xuxian2102/autolock/reports/D5_POLARITY_DELTA_AUDIT.md

# D5 polarity delta audit

- Result: **PASS**
- Baseline SHA256: `0b13ca1eb79be087c1f54d9761513777bbcf02e400407ef353ba8222105b63a9`
- PCB exact approved transform: `True`
- Segment/via records byte-identical: `True`
- D5 pad centers swapped in place: `True`
- MCU schematic exact approved transform: `True`
- Design contract matches: `True`
- Errors: `0`
