xuxian2102/autolock/reports/GRAPHICS_SYNC_REGRESSION_STATUS.md

# Rev A 第二批图形封装同步回归状态

## 范围

- 仅处理 `C1、D1、D2、D5、F1、F2、J3、J4、L3、L4、Q1` 共 11 个实例；
- 同步隐藏 Value、参考号层、无效丝印弧等非铜层定义；
- 将 33 个文字子项和 29 个焊盘子项改为 KiCad 板坐标角度；
- Q1 修正一个被旧格式错误解释的 F.SilkS 弧，并移除重复的 footprint 自定义 `LCSC Part` 属性；
- 明确未处理 J2、U4、U5，也未修改其库或板上实例。

## 回归结果

| 检查 | 结果 |
|---|---|
| KiCad 10.0.6 官方 DRC | 仅 3 条 `lib_footprint_mismatch`：J2、U4、U5 |
| 官方未连接项 | 0 |
| 不同网络几何净距审计 | 0 errors，0 warnings |
| 物理铜连接 | 68 / 68 网络通过 |
| 非目标 PCB footprint | 未改变 |
| 走线、铜区、板级图形、网络 | 未改变 |
| 原理图 | 全部未改变 |
| 项目库变更集合 | 9 / 9 个预期文件，无额外文件 |
| 制造导出审计 | 13 / 13 文件，0 errors |
| 制造几何与上一归档对比 | 13 / 13 一致；仅生成时间不同 |
| 隔离重建测试 | 新生成 PCB 仍只剩 J2、U4、U5 三条库不匹配 |

## Q1 料号说明

`C16072` 没有从项目数据中删除。它仍存在于 `design_data.py`、原理图属性和 BOM 中。只删除了 Q1 板上 footprint 内重复的一份自定义属性，因为该副本的默认字体/格式语义会导致 KiCad 将板上实例判定为与项目库不一致。

## 结论

第二批 11 个图形封装同步通过官方 DRC、范围差分、连接、几何、制造导出和隔离重建验证。项目继续保持 **HOLD**；剩余 J2/U5 铜层关键差异和 U4 结构差异需要各自独立处理。
