xuxian2102/autolock/reports/PASSIVE_SYNC_REGRESSION_STATUS.md

# Rev A 第一批无源封装同步回归状态

## 范围

- 仅处理原 KiCad 10 DRC 报告中的 58 个常见无源实例；
- `C_0603_1608Metric`：28 个；
- `R_0603_1608Metric`：20 个；
- `C_1206_3216Metric`：10 个；
- 新增 6 个项目内封装变体，用于分别表达 `F.SilkS` 参考号和 `F.Fab` 参考号；
- 明确未处理：J2、U4、U5，以及所有不在 58 个引用清单中的实例。

## 回归结果

| 检查 | 结果 |
|---|---|
| PCB 库关联改动 | 58 / 58，符合清单 |
| 原理图 Footprint 属性改动 | 58 / 58，符合清单 |
| 目标器件旋转语义 | 174 个文字子项角度、116 个焊盘子项角度已改为 KiCad 板坐标角度 |
| 目标器件焊盘编号、网络、中心坐标、尺寸与形状 | 未改变 |
| 非目标 PCB footprint | 未改变 |
| 走线、铜区、板级图形、网络 | 未改变 |
| 非目标原理图符号及其他字段 | 未改变 |
| 不同网络几何净距审计 | 0 errors，0 warnings |
| 物理铜连接 | 68 / 68 网络通过 |
| 制造导出审计 | 13 / 13 文件，0 errors |
| 制造几何与同步前归档对比 | 13 / 13 一致；仅 Gerber CreationDate 不同 |
| BOM/CPL | 95 个 BOM 引用，93 个 CPL 引用，21 个 LCSC 仍待确认 |

## 封装告警复核

同步前的 KiCad 10.0.5 官方 DRC 文件包含 72 条 `lib_footprint_mismatch`。重新取得官方 KiCad 10.0.6 后，对正式修正板运行原生 DRC：

- 原生 DRC 总违规：14，且全部为 `lib_footprint_mismatch`；
- 未连接项：0；
- 已消除本批 58 条；
- 图形/字段差异：11；
- U4 结构复核：1；
- J2/U5 铜焊盘复核：2；
- 合计仍保留：14。

正式报告为 `KICAD10_DRC_PASSIVE_ROTATION_FIXED_OFFICIAL.json`，其中记录 `kicad_version: 10.0.6`。另外以同步完成后的归档为基线做严格差分：58 个目标之外的 footprint、板级数据与全部原理图未变，13 份制造文件物理几何一致。

## 结论

第一批 58 个无源封装同步本身通过范围、连接、几何和制造回归。项目继续保持 **HOLD**，本批之外的 14 条封装告警没有被处理。
