xuxian2102/autolock/reports/REV_A_RELEASE_STATUS.md

# Rev A 发布状态

## 已完成

- 120 个 PCB footprint、68 个电气网络；
- 4 层 150 × 75 mm 布线；
- 真实自定义焊盘几何纳入审计；
- 68/68 网络物理铜皮连通；
- 不同网络最小 0.10 mm 净距审计：0 errors、0 warnings；
- NFC 与 ESP32 天线四层禁铜检查；
- PN7161 中心焊盘采用 NXP SOT618-1 官方 3 × 3、0.60 × 0.60 mm 钢网开窗，约 19.3% 锡膏面积；
- KiCad 10.0.6 官方导出的 11 层 Gerber 与 PTH/NPTH Excellon，共 13 个文件；已检查 X2 属性、毫米单位、文件结尾及钻孔数量；
- PTH 240 圆孔 + 4 长槽、NPTH 6 圆孔与源板数量一致；
- JLC BOM 草稿、CPL 草稿、顶层装配图、分层铜皮预览；
- 裸板上传 ZIP 和完整评审包。
- 第一批 58 个常见无源封装已完成项目库同步，并补齐旋转实例的 174 个文字子项角度与 116 个焊盘子项角度；
- 第二批 11 个图形/字段类封装已同步；其中 Q1 的错误丝印弧已改为正确的小型引脚 1 缺口，重复的 footprint 级 LCSC 属性已移除，但 `C16072` 仍保留在设计清单、原理图与 BOM；
- KiCad 10.0.6 原生 DRC 已正式复跑：`lib_footprint_mismatch` 从 72 条降至 0 条，0 个未连接项、0 条违规；
- U4 已换成 KiCad 10 原生 footprint 块并同步项目库；专用基线差分确认 61 个焊盘、网络、四层天线禁铜区、位置及制造几何均未改变；
- J2 已按 HRO TYPE-C-31-M-12 的机械结构完成复核：两个 0.60 mm 塑料定位柱孔保持 NPTH，18 个焊盘/外壳固定脚的铜、钻孔、网络和物理方向未改变；
- U5 已按 NXP SOT618-1 官方封装复核：40 个外围焊盘和 4.10 × 4.10 mm 中心铜焊盘保持不变；只把错误的整面锡膏改为九个 0.60 mm 开窗，并把 courtyard 改为 7.25 × 7.25 mm；
- U5 专用基线差分通过：U5 之外的 PCB 文本逐字节一致，41 个铜焊盘、网络、位置和物理方向均未变化；13 份制造文件中只有顶层锡膏层发生预期变化；
- 生成链已在隔离副本中重建验证：全新生成 PCB 为 0 条封装库不匹配，U4、J2、U5 与此前两批同步均不会回退。
- 原 21 个采购料号缺口已全部完成 LCSC/MPN/厂家复核并同步到设计源、原理图和 BOM；
- D5 已按标准 LED 极性修正：1=K 接 GND、2=A 经 R9 接 `STATUS_LED`，采用 C12624 / KT-0603G；D5 原地旋转 180°，全部走线和过孔逐字节未变；
- D5 专用基线差分、项目几何检查、68/68 物理连通和 KiCad 10 PCB DRC 均通过，DRC 为 0 条违规、0 个未连接。
- 一键发布链已固化为：项目几何/连通检查 → KiCad 10 官方 DRC → 兼容 BOM/CPL 导出 → KiCad 10 官方制造文件覆盖 → 13/13 制造审计 → CPL 93/93 定位/旋转审计 → 官方逐层图渲染；fallback Gerber 不会进入最终 ZIP；
- 官方逐层图本地目检通过：左侧 NFC 区域内层禁铜、U4 板边天线下方四层留空、U5 顶层钢网为 3 × 3，丝印文字和圆弧均保留；
- CPL 本地语义审计通过：93/93 个顶层 SMT 位号、中心坐标、层面和板内旋转与 PCB 一致；D5 为 270°。嘉立创元件库模型的零度定义仍必须在网页预览中确认。

## 尚未放行

1. 嘉立创 PCBA 预览中尚未逐颗确认旋转，尤其 D5 阴极方向；
2. 官方 Gerber 已在本地逐层目检，但尚未在嘉立创在线查看器中确认其平台解析结果；
3. PCB 天线没有实板 VNA 调谐，HomeKey 穿门距离未知；
4. 固件、待机功耗、舵机机构和堵转保护尚未验证。
5. 当前便携 KiCad 的原理图 ERC/PDF 子命令对未修改基线也会 bus error；`.kicad_sch` 源文件是权威版本，现有 PDF 仍是 D5 修正前版本。

结论：**电气与导出完整性通过；生产放行保持 HOLD。**
