xuxian2102/autolock/reports/FINAL_LOCAL_PRODUCTION_REVIEW.md

# Rev A 最终本地生产评审

## 结论

**本地电气、几何、制造导出和装配坐标回归全部通过；生产状态保持 HOLD。**

HOLD 不代表本地审计失败，而是仍缺嘉立创网页解析确认、实时库存确认和首板 RF/电源/机构测试。当前文件可以用于进入嘉立创上传预览阶段，但不应在未复核预览的情况下直接付款。

## 已通过的发布门

| 检查项 | 结果 |
|---|---|
| D5 受控基线差分 | PASS；只发生批准的极性/朝向/采购字段变化，走线和过孔逐字节未变 |
| 项目几何审计 | PASS；0 errors / 0 warnings，最小审计净距 0.10 mm |
| 物理铜连接 | PASS；68/68 个有焊盘网络连通，0 个断网 |
| KiCad 10.0.6 官方 PCB DRC | PASS；0 violations / 0 unconnected |
| 制造导出 | PASS；KiCad 官方 11 层 Gerber + PTH/NPTH，共 13/13 文件 |
| 钻孔 | PASS；PTH 240 圆孔 + 4 长槽，NPTH 6 圆孔 |
| BOM | PASS；95 个有效位号，SMT 缺失 LCSC 数为 0 |
| CPL | PASS；93/93 个顶层 SMT 位号、中心坐标、层面和板内旋转一致 |
| 官方逐层图 | PASS；11 层及 D5/U5/U4/J2 四个关键区域已渲染复核 |

## 制造图关键确认

- 最终制造文件全部来自 KiCad 10.0.6 官方导出；兼容导出只提供中间数据，发布链会在审计与打包前强制由官方文件覆盖。
- 顶层/底层丝印保留参考文字、板名和圆弧，不存在 fallback 的文字/旧式圆弧缺失。
- 左侧 NFC 天线完整，内层在 NFC 区域保持禁铜。
- U4 位于板边，其天线下方 F.Cu、In1.Cu、In2.Cu、B.Cu 四层均留空。
- U5 中心铜焊盘保持 4.10 × 4.10 mm，顶层钢网为九个 0.60 × 0.60 mm 分窗。
- J2 的两个 0.60 mm 定位柱孔为 NPTH，四个外壳固定脚为镀铜长槽。
- D5 为 C12624 / KT-0603G，CPL 旋转 270°；1/K 接 GND，2/A 经 R9 接状态灯网络。

## 发布链顺序

1. 几何与物理连通审计；
2. KiCad 10 官方 PCB DRC；
3. BOM/CPL 与兼容制造数据生成；
4. KiCad 10 官方 Gerber/钻孔覆盖；
5. 固定 13 文件集合、格式、钻孔和装配数据审计；
6. CPL 93/93 定位/旋转审计；
7. KiCad 官方逐层图与关键区域渲染；
8. Gerber ZIP、评审包与 SHA-256 清单生成。

任何步骤失败都会中止构建，不会生成新的发布包。

## 尚未完成的外部放行门

1. 在嘉立创 Gerber 查看器确认 4 层顺序、板框、长槽、NFC/U4 禁铜和 U5 钢网；
2. 在嘉立创 PCBA 预览逐颗确认库模型零度定义，重点检查 D5、J2、U4、U5 和 X1；
3. 下单前重新确认 LCSC 实时库存、替代提示和混装工艺；
4. 首板完成 NFC 天线 VNA 调谐、HomeKey 穿门距离测试；
5. 首板完成固件、待机功耗、舵机电源、堵转保护和机构验证。

## 原理图 PDF 限制

当前便携 KiCad 10 的原理图 ERC/PDF 子命令在修正前基线和当前文件上都会触发 `bus error`。因此 `.kicad_sch` 是权威原理图；现有 PDF 仍是 D5 修正前的参考版本并已明确标注，不得据其判断 D5 极性。该限制不影响 PCB DRC、Gerber、钻孔、BOM 或 CPL 的官方导出和审计。
