xuxian2102/autolock/reports/PCB_CONNECTIVITY.csv

Net | Layer policy | Unique endpoints | MST edges | New vias | A* visited nodes | Status
BAT_SYS | F.Cu/In2.Cu | 14 | 13 | 14 | 0 | PASS (explicit current tree)
PN_VMID | F.Cu | 2 | 1 | 143 | 4 | PASS
PN_TX1 | F.Cu | 2 | 1 | 143 | 451 | PASS
PN_TX2 | F.Cu | 2 | 1 | 143 | 857 | PASS
PN_RXN | F.Cu | 2 | 1 | 143 | 1327 | PASS
PN_RXP | F.Cu | 2 | 1 | 143 | 5717 | PASS
RF_N0 | F.Cu | 5 | 4 | 143 | 1803 | PASS
RF_N1 | F.Cu | 5 | 4 | 143 | 515 | PASS
RF_P0 | F.Cu | 5 | 4 | 143 | 2509 | PASS
RF_P1 | F.Cu | 5 | 4 | 143 | 840 | PASS
ANT_P | F.Cu | 2 | 1 | 143 | 87 | PASS
RF_N2 | F.Cu | 3 | 2 | 143 | 2118 | PASS
RF_P2 | F.Cu | 3 | 2 | 143 | 1863 | PASS
ANT_N | F.Cu | 2 | 1 | 143 | 87 | PASS
EXT_ANT_N | F.Cu | 2 | 1 | 143 | 1203 | PASS
EXT_ANT_P | F.Cu | 2 | 1 | 143 | 449 | PASS
RXN_AC | F.Cu | 2 | 1 | 143 | 2 | PASS
RXP_AC | F.Cu | 2 | 1 | 143 | 2 | PASS
XTAL1 | F.Cu | 3 | 2 | 143 | 1467 | PASS
XTAL2 | F.Cu | 3 | 2 | 143 | 9484 | PASS
SERVO_PWM | F.Cu | 2 | 1 | 143 | 146601 | PASS
SERVO_6V | F.Cu | 7 | 6 | 141 | 15796 | PASS
SERVO_6V_OUT | F.Cu | 3 | 2 | 141 | 73543 | PASS
SW_SERVO | F.Cu | 3 | 2 | 141 | 249 | PASS
BAT_FUSED | F.Cu | 6 | 5 | 141 | 1294 | PASS
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
