xuxian2102/autolock/reports/PHYSICAL_CONNECTIVITY_AUDIT.txt

PHYSICAL COPPER CONNECTIVITY AUDIT
========================================================================
Electrical nets with pads checked: 68
Disconnected nets: 0

RESULT: PASS — every electrical net's component terminals share copper
