xuxian2102/autolock/reports/final-review/B_Cu.png

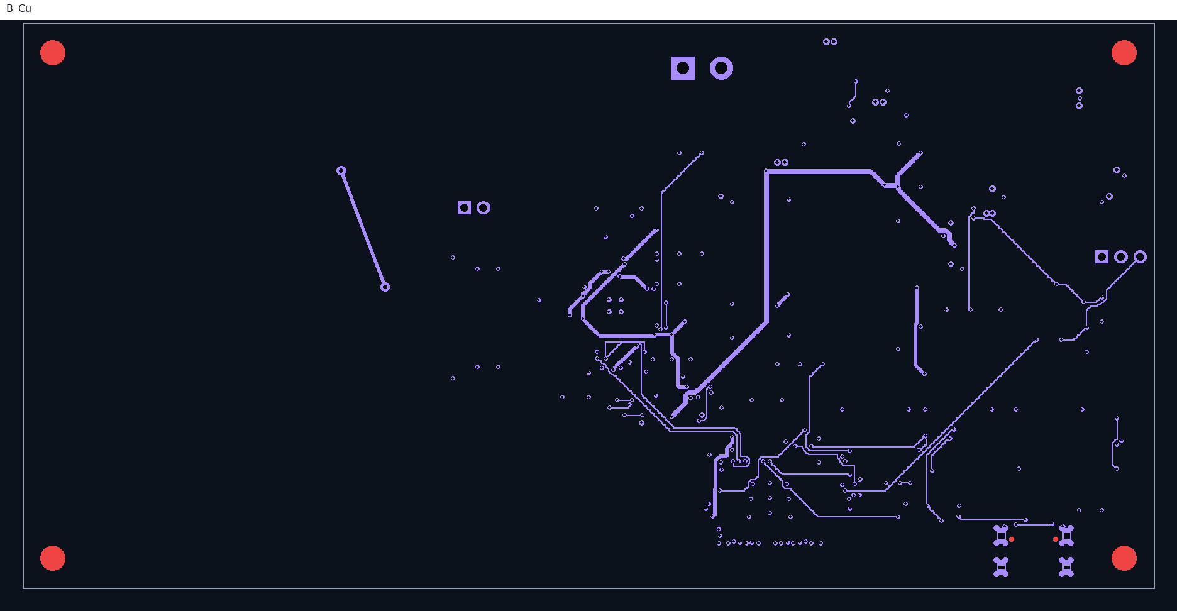
reports/final-review/B_Cu.png
