xuxian2102/autolock/reports/final-review/B_Mask.png

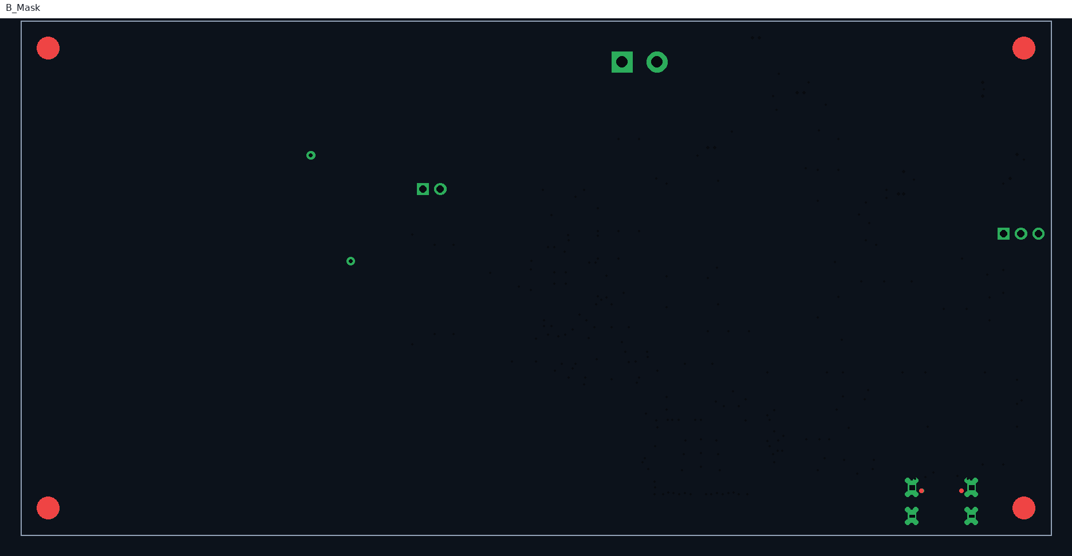
reports/final-review/B_Mask.png
