xuxian2102/autolock/reports/final-review/B_Paste.png

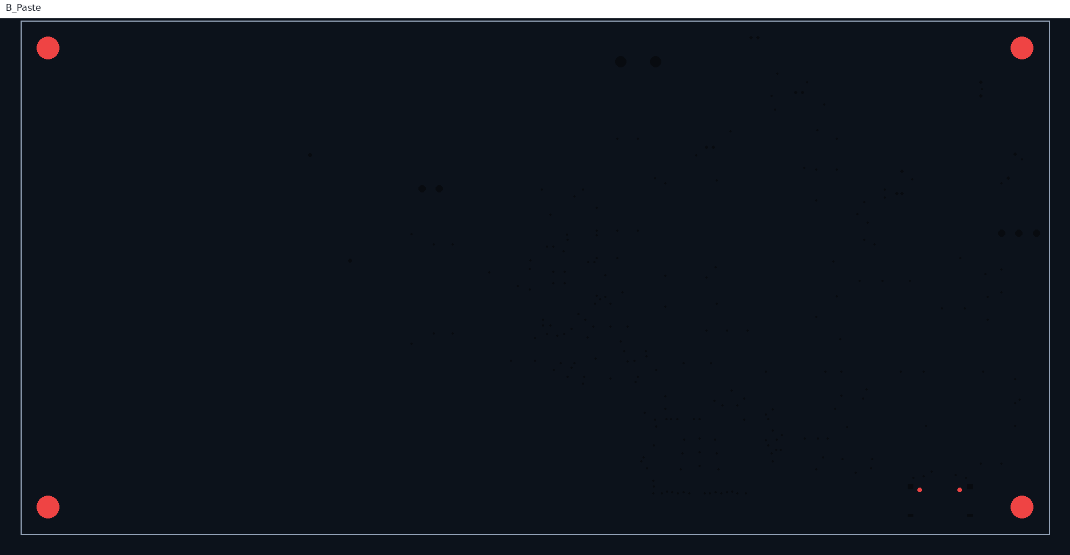
reports/final-review/B_Paste.png
