xuxian2102/autolock/reports/final-review/cpl_orientation_overlay.png

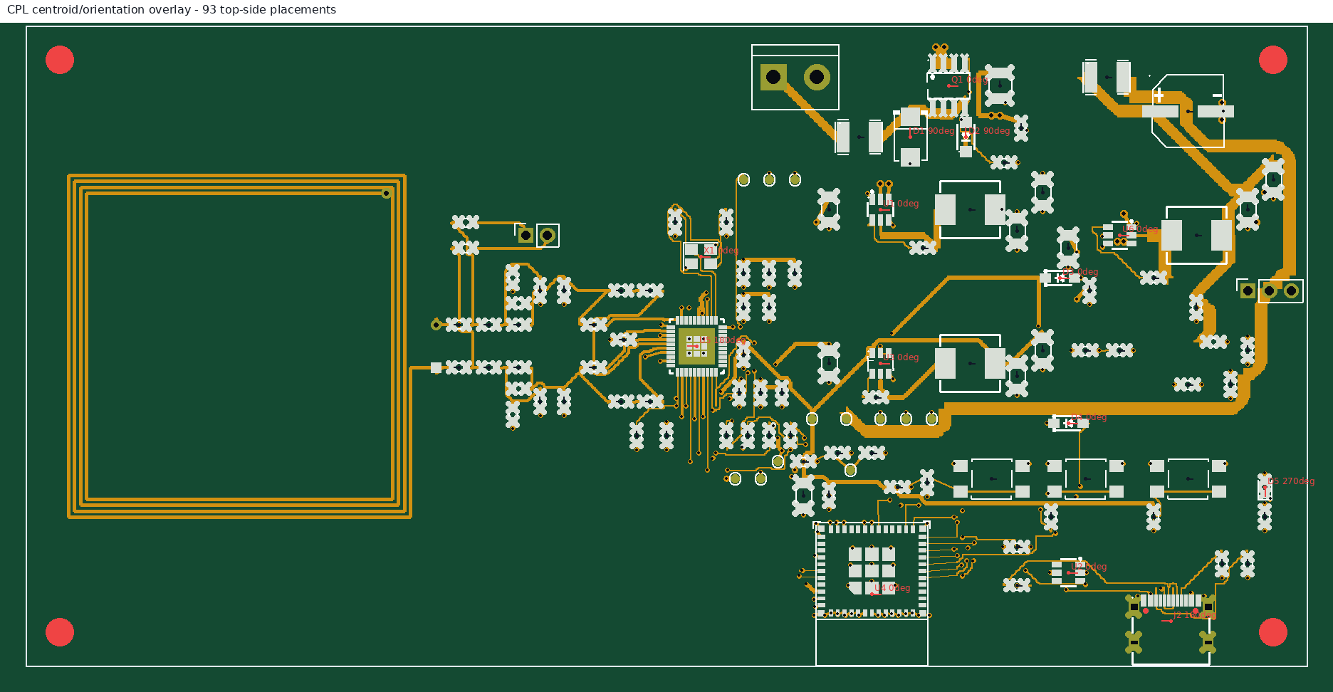
reports/final-review/cpl_orientation_overlay.png
