xuxian2102/autolock/reports/final-review/critical_crops.png

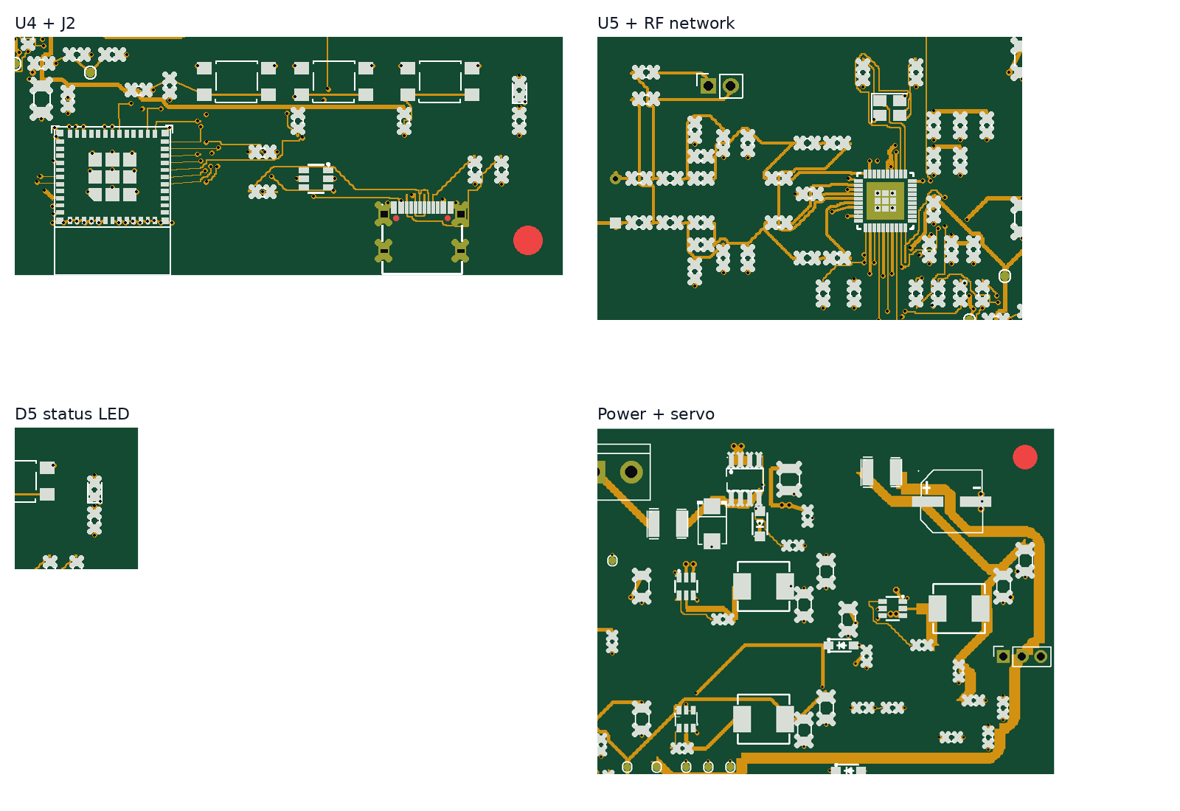
reports/final-review/critical_crops.png
