xuxian2102/autolock/reports/final-review/drill_map.png

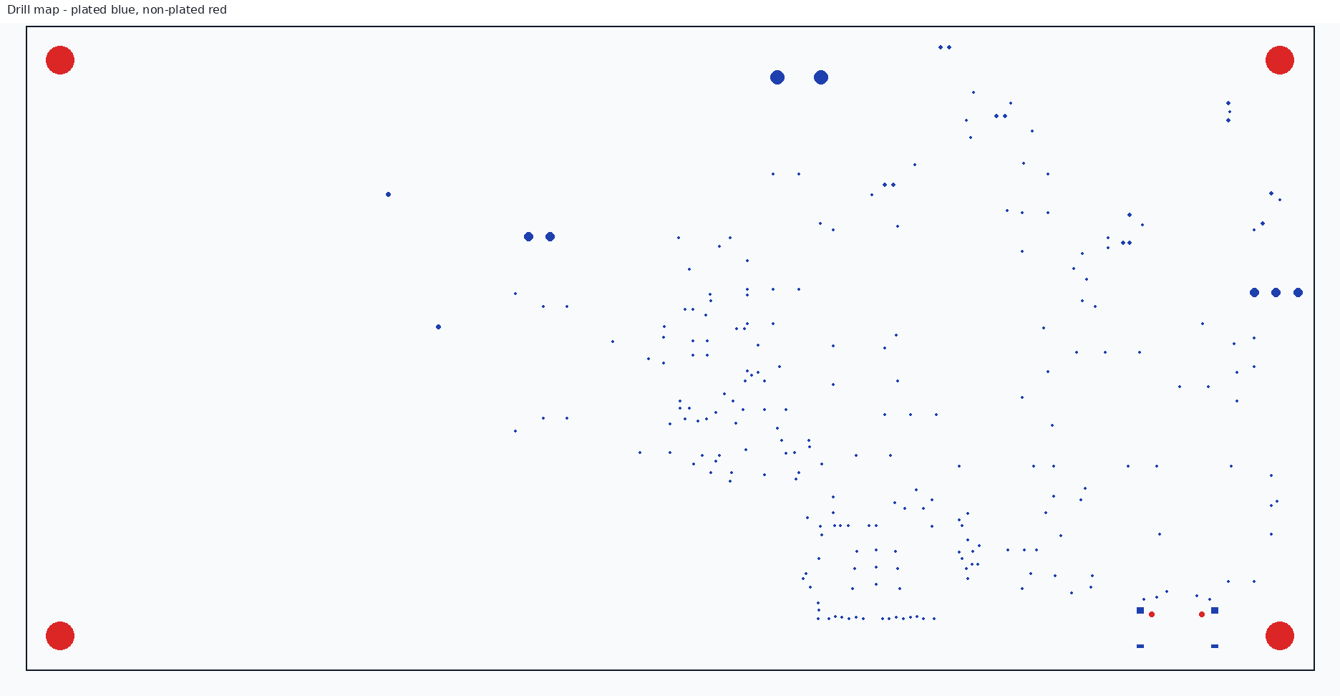
reports/final-review/drill_map.png
