xuxian2102/autolock/reports/final-review/F_Mask.png

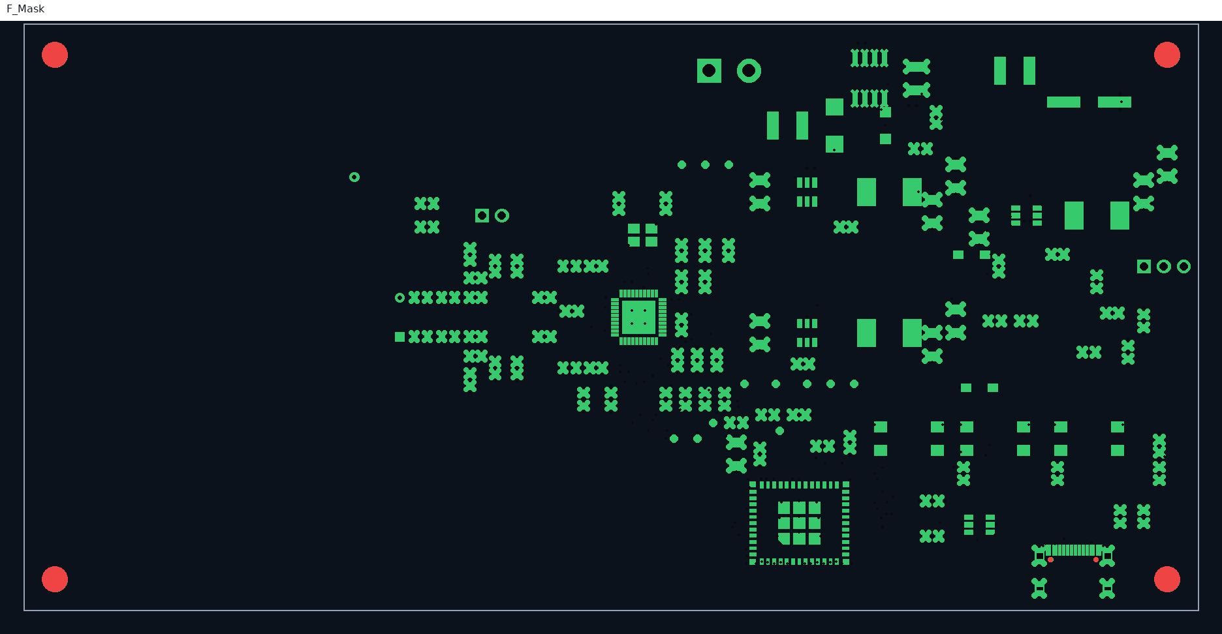
reports/final-review/F_Mask.png
