xuxian2102/autolock/reports/final-review/F_Paste.png

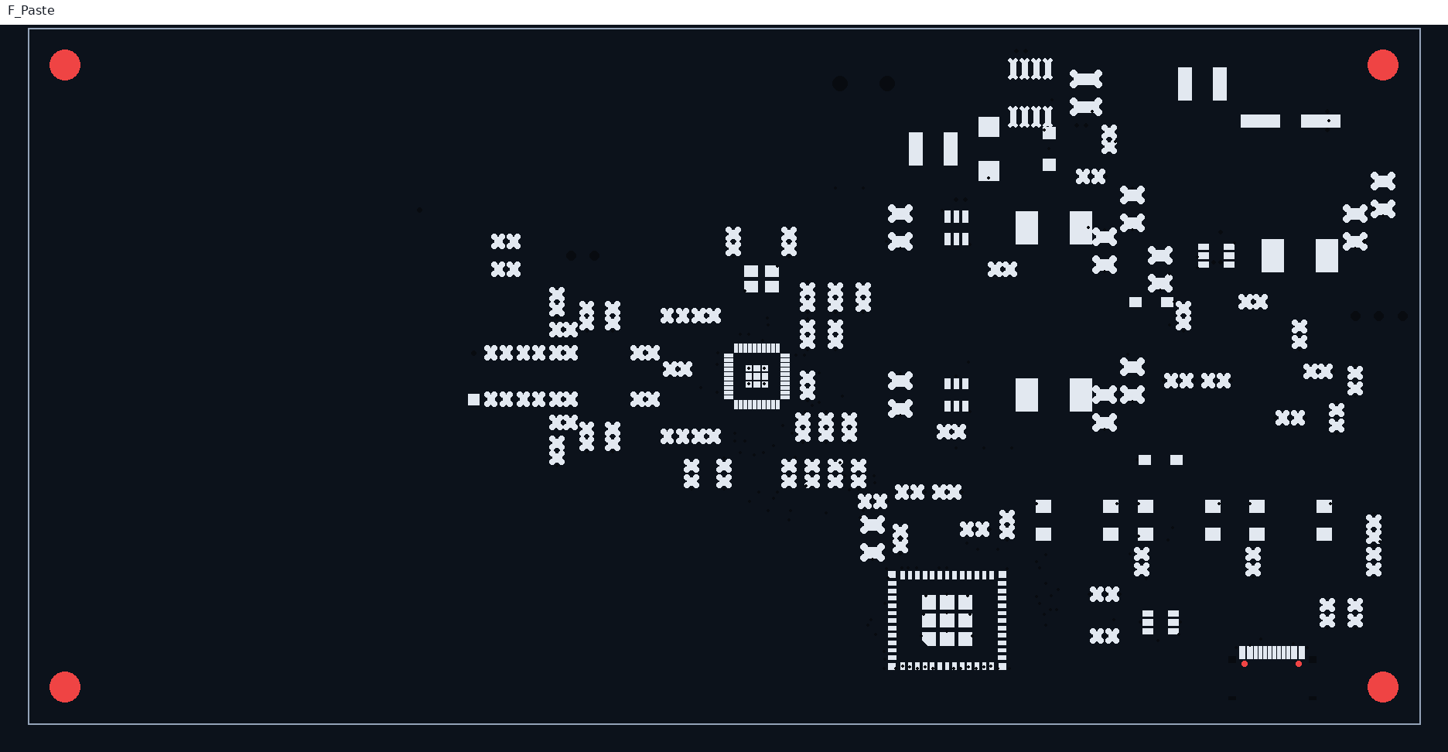
reports/final-review/F_Paste.png
