xuxian2102/autolock/reports/final-review/F_Silk.png

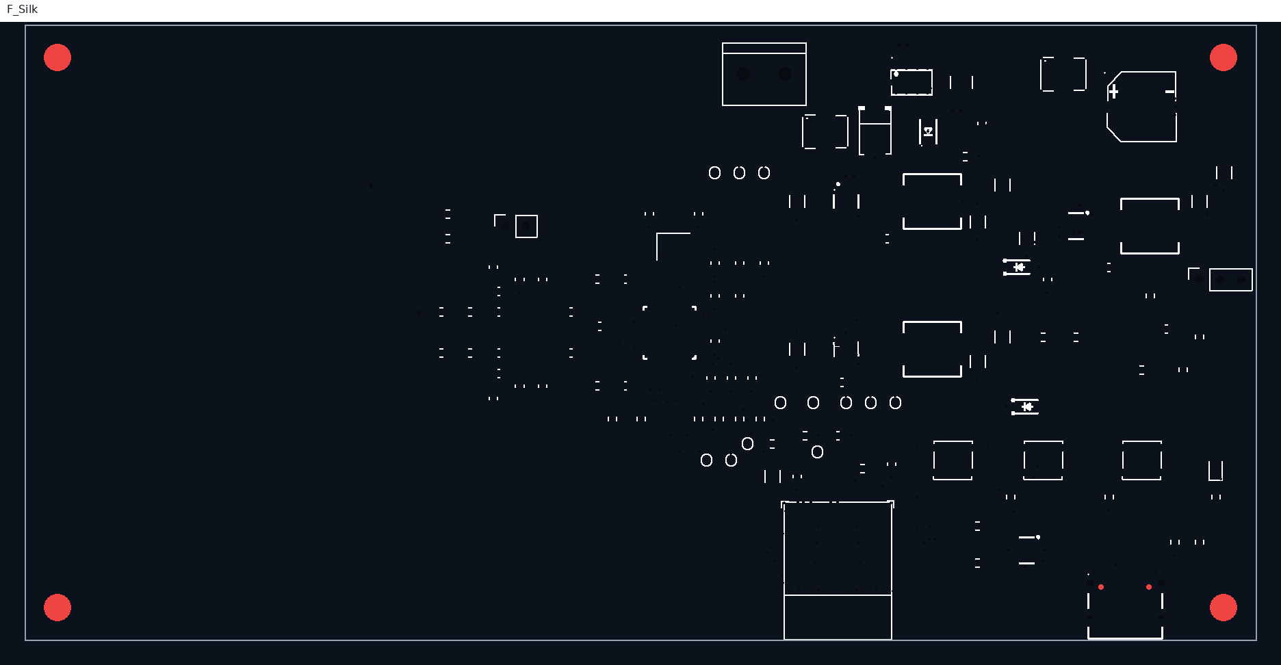
reports/final-review/F_Silk.png
