xuxian2102/autolock/reports/final-review/In1_Cu.png

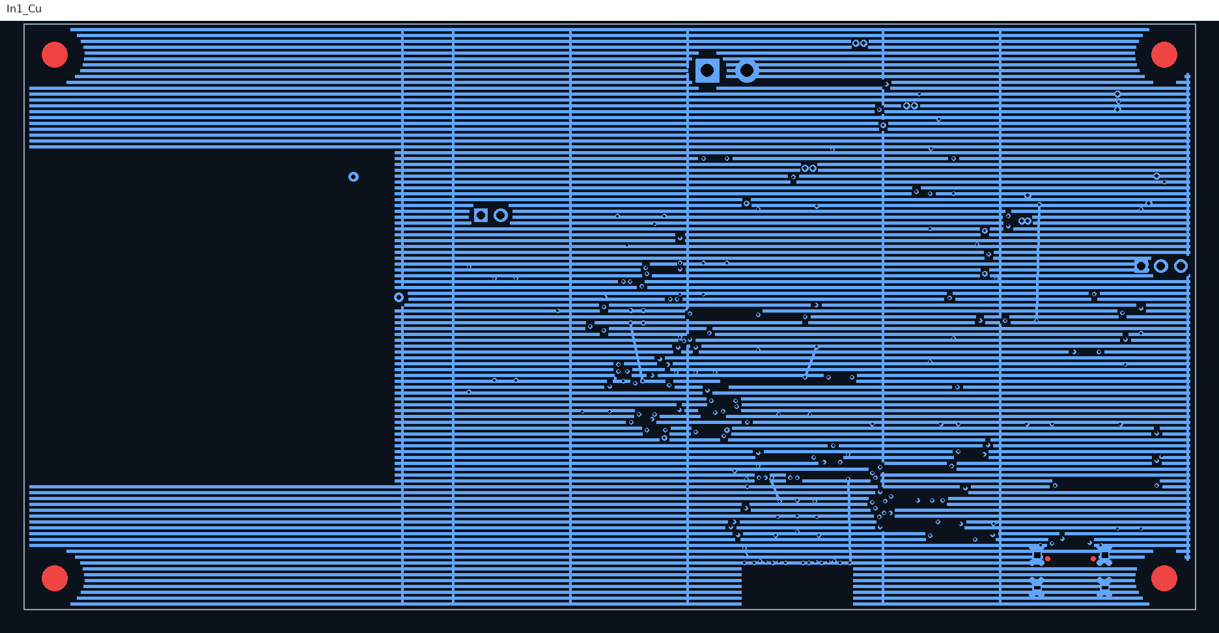
reports/final-review/In1_Cu.png
