xuxian2102/autolock/reports/final-review/In2_Cu.png

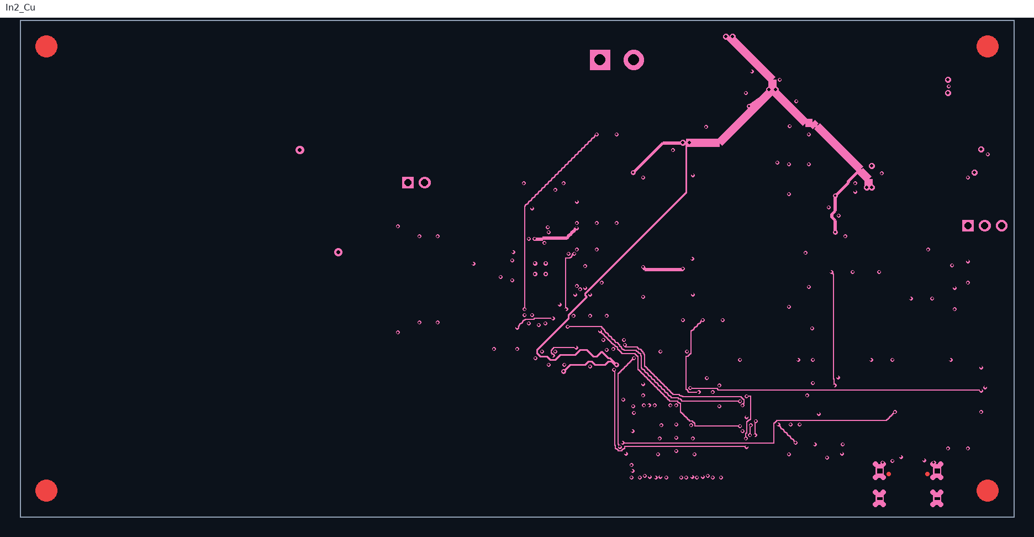
reports/final-review/In2_Cu.png
