xuxian2102/autolock/reports/final-review/official-svg/HomeKey-Lock-RevA-PN7161-B_Mask.png

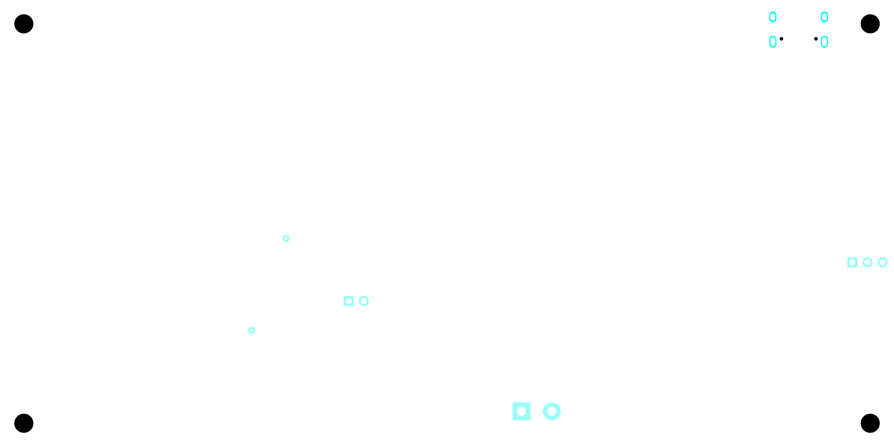
reports/final-review/official-svg/HomeKey-Lock-RevA-PN7161-B_Mask.png
