xuxian2102/autolock/reports/final-review/official-svg/HomeKey-Lock-RevA-PN7161-F_Mask.png

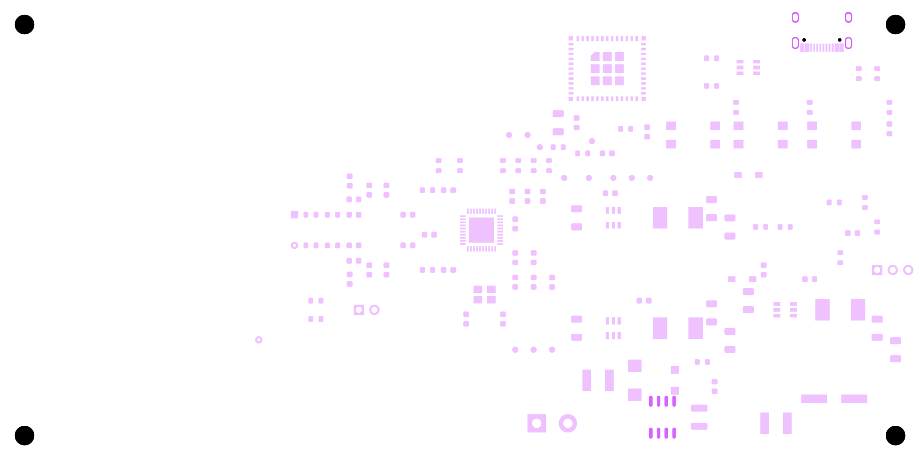
reports/final-review/official-svg/HomeKey-Lock-RevA-PN7161-F_Mask.png
