xuxian2102/autolock/reports/final-review/official-svg/HomeKey-Lock-RevA-PN7161-F_Silkscreen.png

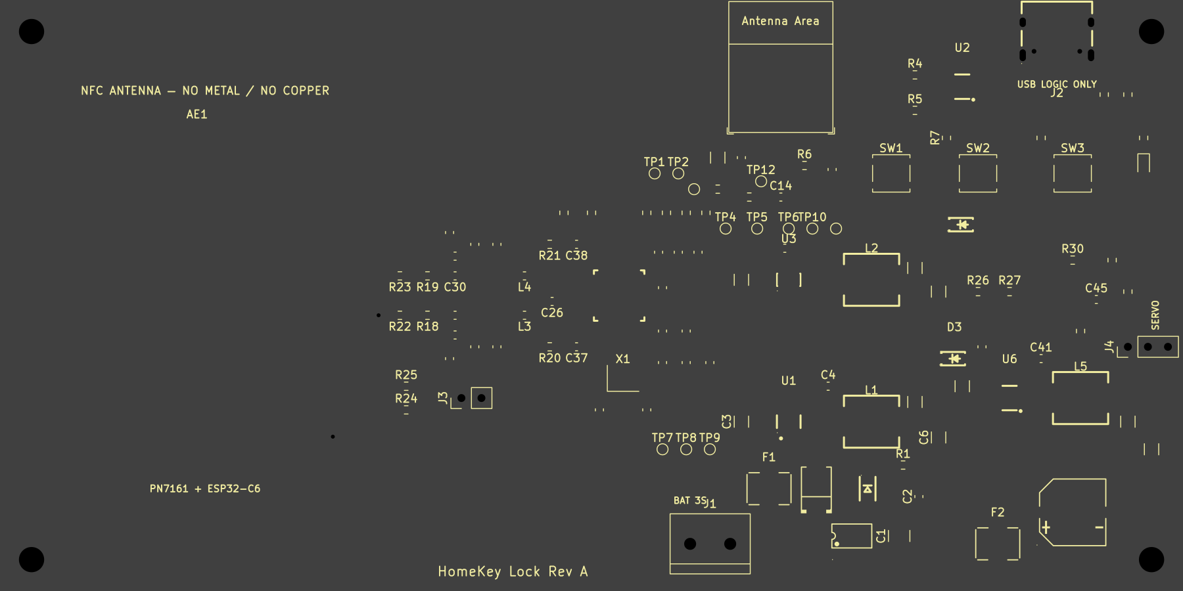
reports/final-review/official-svg/HomeKey-Lock-RevA-PN7161-F_Silkscreen.png
