xuxian2102/autolock/reports/final-review/official-svg/HomeKey-Lock-RevA-PN7161-In1_Cu.png

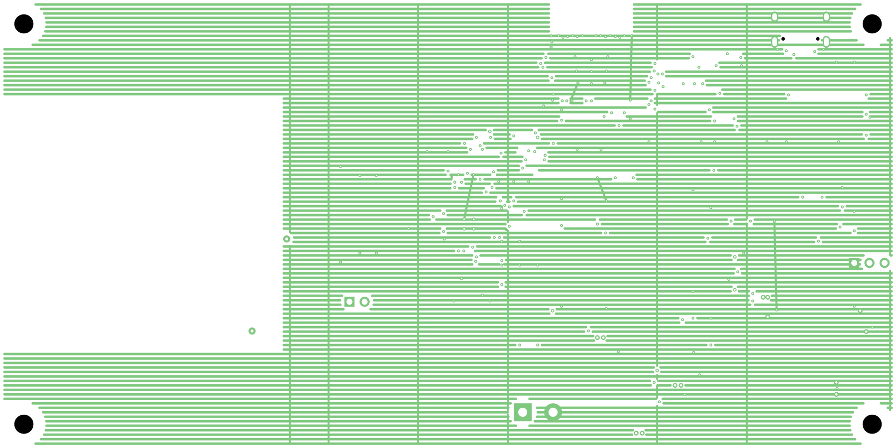
reports/final-review/official-svg/HomeKey-Lock-RevA-PN7161-In1_Cu.png
