xuxian2102/autolock/reports/final-review/official_critical_D5.png

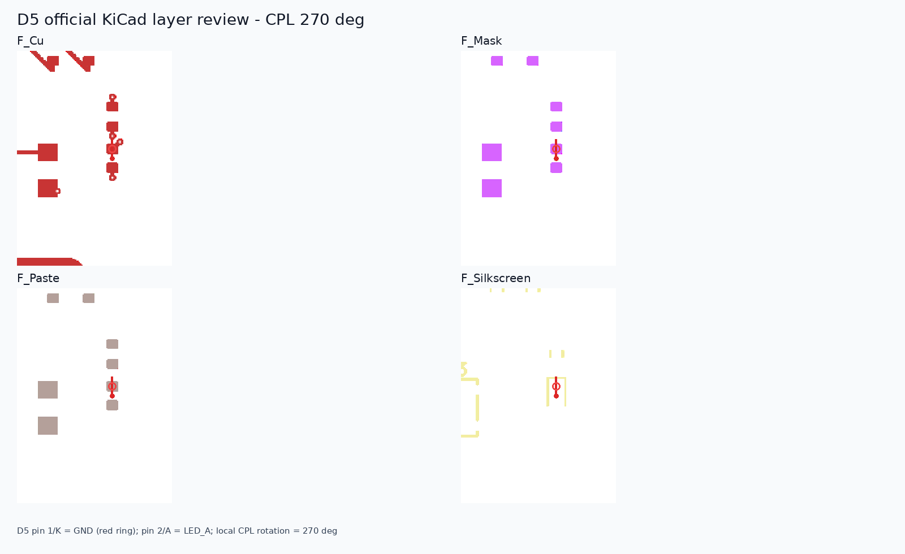
reports/final-review/official_critical_D5.png
