xuxian2102/autolock/reports/final-review/official_critical_J2.png

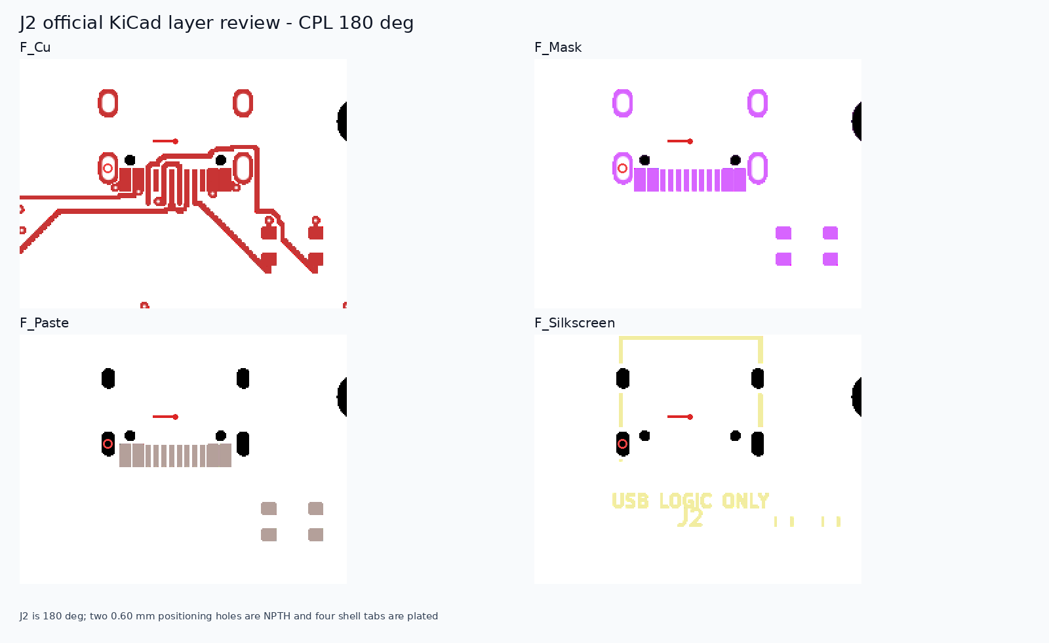
reports/final-review/official_critical_J2.png
