xuxian2102/autolock/reports/final-review/official_critical_U4.png

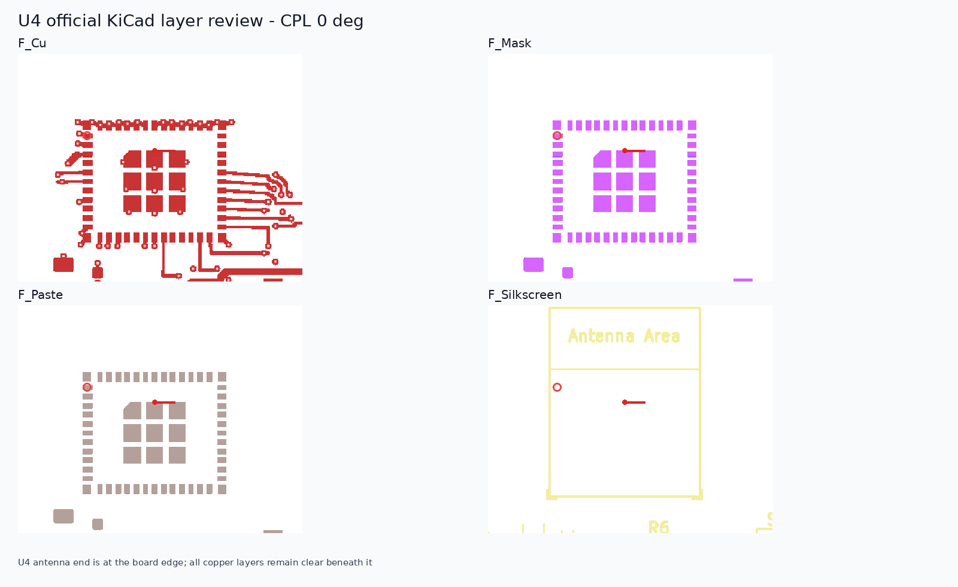
reports/final-review/official_critical_U4.png
