xuxian2102/autolock/reports/layers/copper_layers.png

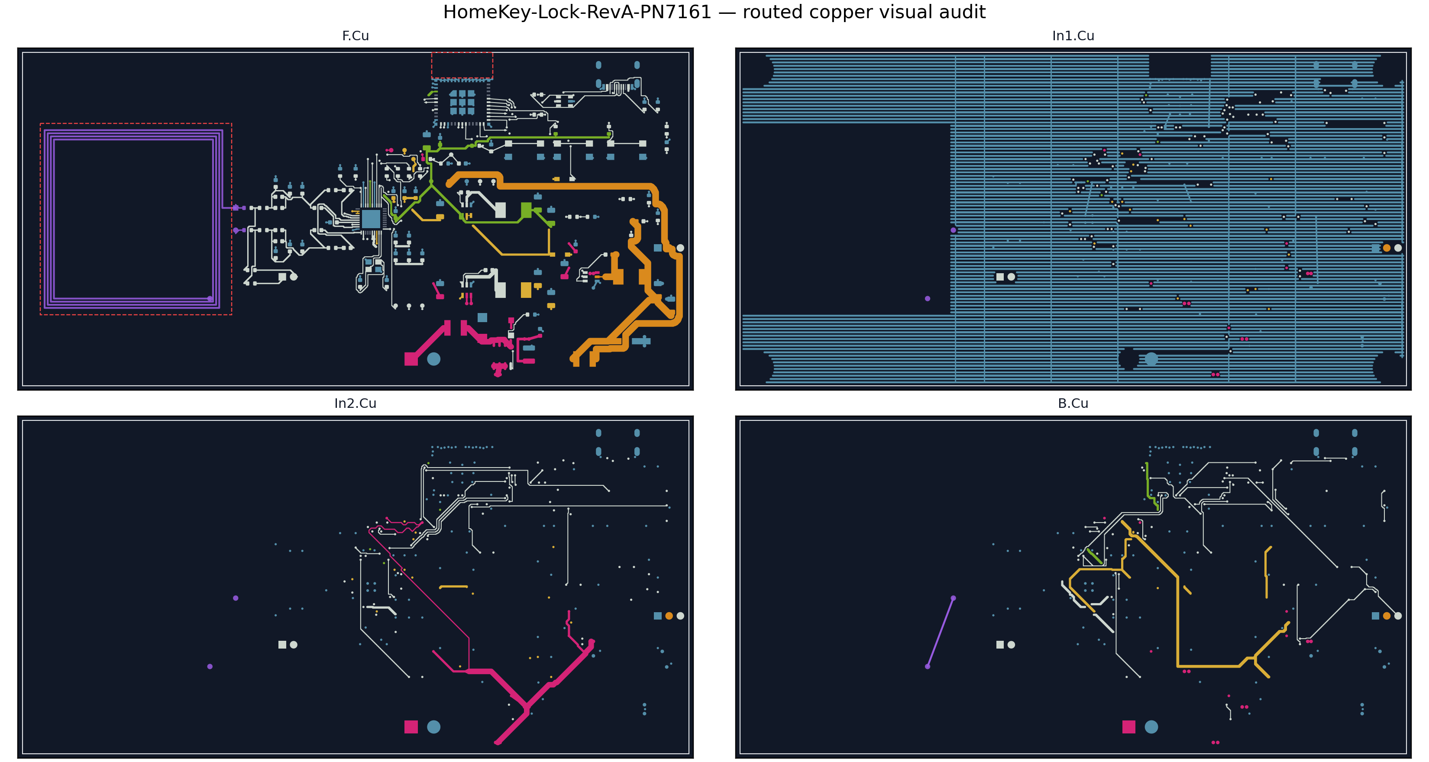
reports/layers/copper_layers.png
