xuxian2102/autolock/reports/layers/power_crop.png

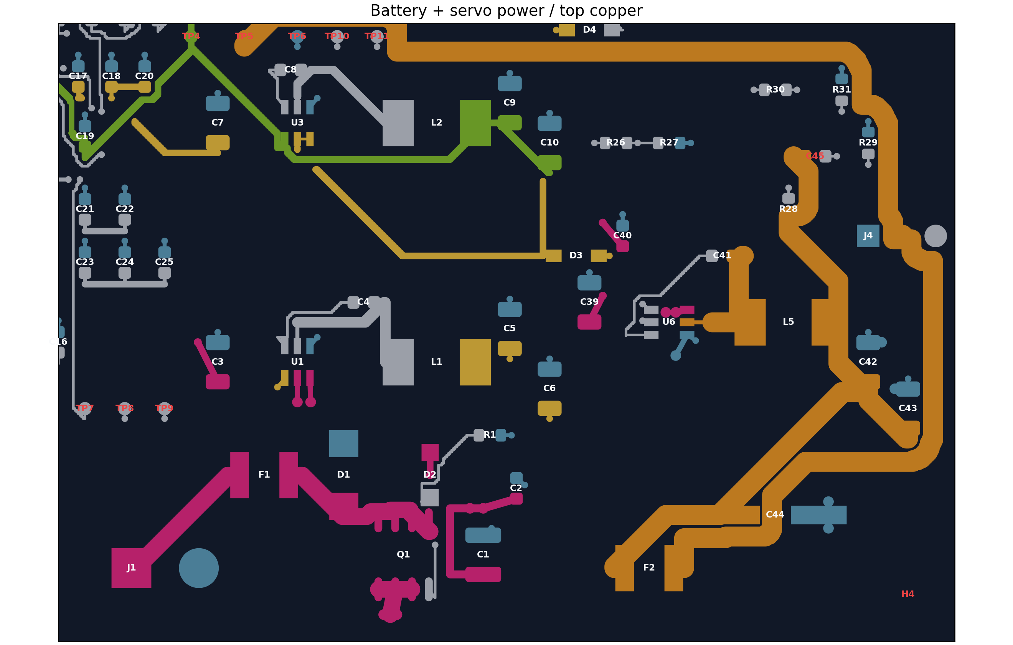
reports/layers/power_crop.png
