xuxian2102/autolock/reports/layers/rf_crop.png

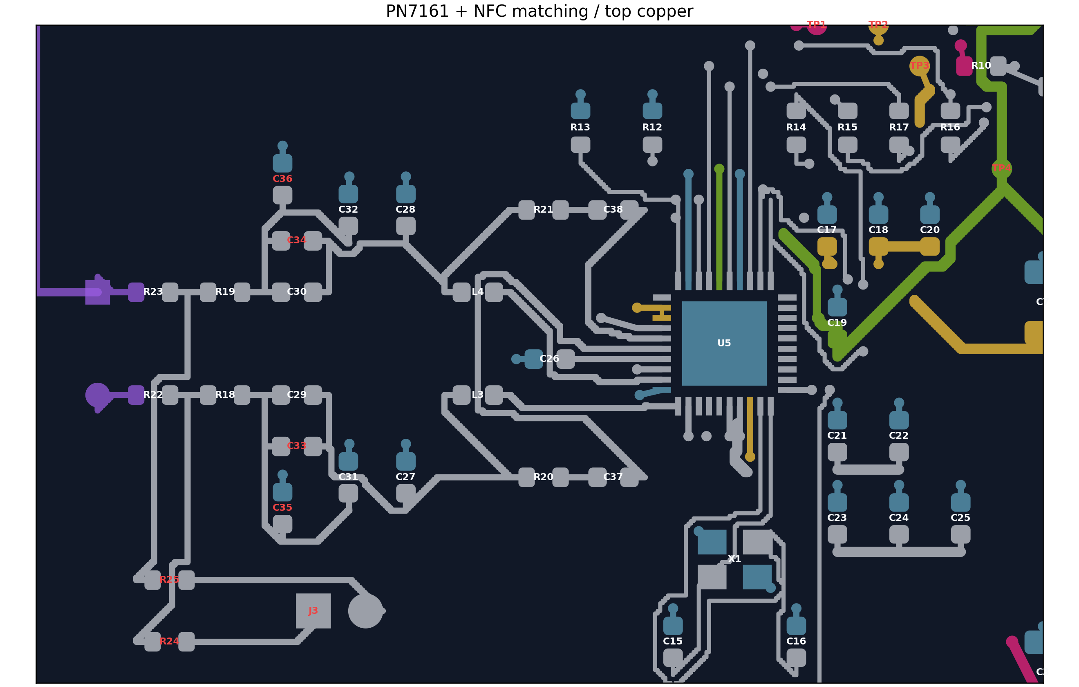
reports/layers/rf_crop.png
