xuxian2102/autolock/reports/layers/usb_crop.png

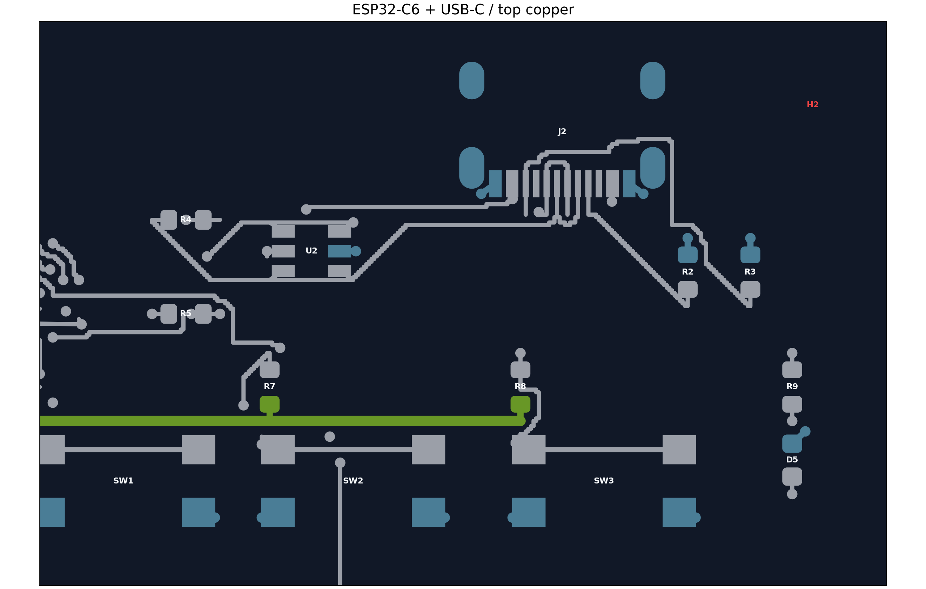
reports/layers/usb_crop.png
