xuxian2102/autolock/hardware/production/JLCPCB_ORDER_NOTES.md

# Rev A 嘉立创下单说明

## 当前放行状态

**裸 PCB：HOLD，先在嘉立创 Gerber 预览器确认 4 层、板框、长槽和天线后再放行。**  
**PCBA：HOLD，料号已齐；仍需在贴片预览中逐颗复核 CPL 旋转，尤其 D5 阴极方向。**

这不是电气审计失败。当前板文件已经通过精确铜皮净距检查（0 errors / 0 warnings）、68/68 网络物理连通检查和 KiCad 10 官方 PCB DRC（0 条违规、0 个未连接）；HOLD 来自线上 Gerber/CPL 预览和实板 RF/机构验证尚未完成。

## PCB 参数

| 项目 | 选择 |
|---|---|
| 层数 | 4 层 |
| 尺寸 | 150 × 75 mm |
| 板厚 | 1.6 mm |
| 铜厚 | 外层/内层 1 oz（首版） |
| 表面处理 | 推荐沉金 ENIG，便于 NFC/RF 样机焊接与返修 |
| 阻焊 | 任意；首版推荐黑色或绿色 |
| 最小线宽/间距 | 设计审计下限 0.10 mm；下单应选支持 0.10/0.10 mm 的工艺 |
| 最小过孔 | 成品孔 0.20 mm、焊盘 0.50 mm |
| 阻抗 | Rev A 不申请阻抗控制；USB 仅调试，短线；NFC 需实板调谐 |
| 拼板 | 不拼板，5 片 |

上传文件：`hardware/production/gerber.zip`（内含下方 13 个文件，与 `hardware/production/gerbers/` 逐字节一致）。

Gerber 预览必须逐项确认：

1. 识别为 4 层，顺序为 `GTL / G2 / G3 / GBL`；
2. 外形为 150 × 75 mm 闭合矩形；
3. 左侧 40 × 40 mm 四匝天线完整，天线内部没有内层铜；
4. USB-C 外壳的 4 个镀铜长槽出现，另有 4 个 M3 非镀铜孔；
5. PN7161 中心焊盘的钢网为 3 × 3 开窗，而不是整块满锡膏；
6. ESP32 模组板边天线下方四层均无铜；
7. 没有被系统错误镜像或缩放。

## PCBA 参数

- 单面顶层 SMT；J1 电池端子和 J4 舵机排针建议手工焊接。
- J2 USB-C 含 SMT 触点和通孔固定脚，需确认嘉立创工艺是否可贴装该混合封装。
- `BOM_JLCPCB_DRAFT.csv` 与 `CPL_JLCPCB_DRAFT.csv` 仍是 **DRAFT**，必须在嘉立创页面复核实时库存与旋转。
- 原 21 个 LCSC 缺口已全部完成复核；D5 为 C12624 / KT-0603G，CPL 角度 270°，必须以 PCB 阴极标记核对贴片预览。
- 红色/DNP 器件不贴：C33–C36、C45、R24、R25、J3、TP1–TP12。
- AE1 是 PCB 铜天线，不是采购器件。

## 首次上电顺序

1. 不装舵机臂，不接真实门锁；实验电源限流 0.3 A，从 USB 逻辑供电启动。
2. 测 `SYS_5V` 和 `3V3`，确认无短路和异常发热。
3. 用 3S 等效台式电源 9 V、限流 0.5 A，验证 `BAT_SYS`、`5V_BAT`。
4. 暂不使能 U6，检查舵机轨静止；再短时使能并测约 5.94 V。
5. 最后接 DS3115，固件必须先限制 2 s 超时。

## 已知生产链限制

KiCad 10 官方 PCB DRC 已通过。最终 11 层 Gerber 与 PTH/NPTH 钻孔均由 KiCad 10.0.6 官方命令行导出；项目的兼容导出只负责 BOM/CPL 等中间数据，发布链会在打包前强制用官方制造文件覆盖，并对固定的 13 个文件重新审计。官方逐层图已在本地确认丝印文字/圆弧、NFC 内层禁铜、U4 四层天线禁铜和 U5 3 × 3 钢网开窗。

命令行原理图 ERC/PDF 在当前便携 KiCad 环境会发生 bus error，且未修改基线可复现；因此原理图以 `.kicad_sch` 源文件为权威，旧 PDF 明确标注为 D5 修正前版本。本次用 D5 精确基线差分、PCB DRC、物理连通和制造审计补充验证。付款前仍必须使用嘉立创在线 Gerber 与贴片预览器逐层、逐颗确认其解析结果与库模型方向。
