xuxian2102/autolock/reports/OFFICIAL_KICAD10_FABRICATION_EXPORT.md

# Official KiCad 10 fabrication export

- Result: **PASS**
- KiCad: `10.0.6`
- Board: `kicad/HomeKey-Lock-RevA-PN7161.kicad_pcb`
- Files: `13/13`
- Gerber: 11 official X2 layers, metric, 4.6 precision
- Drill: official metric PTH + NPTH Excellon, routed slots
- Silkscreen: reference text and legacy arcs retained

The filename mapping preserves the existing JLCPCB upload contract while replacing every fallback fabrication file with KiCad's official plot output.
