xuxian2102/autolock/hardware/production/assembly/PROCUREMENT_GAPS.md

# PCBA 料号完整性（Rev A）

原 21 个缺口已经全部关闭。D5 的电气极性已修正为 1=K 接 GND、2=A 经 R9 接 `STATUS_LED`，并写入经核对的标准极性 0603 绿光 LED。

**未确认 LCSC 料号：0。**

## 已确认批次

| 位号 | LCSC | 制造商料号 | 核对结果 |
|---|---|---|---|
| C3, C7, C11, C39 | C9807 | CL31A106KAHNNNE | 10 µF、25 V、X5R、1206；同时满足 10 V 与 25 V 位置 |
| R4, R5 | C23345 | 0603WAF220JT5E | 22 Ω、±1%、0603 |
| SW1, SW2, SW3 | C2886899 | TL3305AF160QG | SPST-NO、4.5 × 4.5 mm、gull-wing；与项目 TL3305A footprint 对应 |
| R9 | C21190 | 0603WAF1001T5E | 1 kΩ、±1%、0603 |
| R11 | C22961 | 0603WAF2203T5E | 220 kΩ、±1%、0603 |
| C27, C28 | C882521 | GRM1885C1H331FA01D | 330 pF、C0G/NP0、±1%、50 V、0603（优于设计 ±2%） |
| C29, C30 | C237335 | GRM1885C1H680FA01D | 68 pF、C0G/NP0、±1%、50 V、0603（优于设计 ±2%） |
| R18, R19 | C22946 | 0603WAF270KT5E | 2.7 Ω、±1%、0603 |
| R20, R21 | C4190 | 0603WAF2201T5E | 2.2 kΩ、±1%、0603 |
| R30 | C22962 | 0603WAF2200T5E | 220 Ω、±1%、0603 |
| D5 | C12624 | KT-0603G | 0603 绿光 LED；标准极性 1=K、2=A，PCB 实例旋转 270° |

选择原则：

- 下单前仍须在嘉立创 BOM 匹配页复查当日库存和可贴装状态；料号已确认不代表库存永久锁定。
- RF 电容必须保持 C0G/NP0；首板调谐仍需另外备相邻值，不能把本批初装值视为最终天线匹配值。
- 开关和 D5 必须在贴片预览中逐颗核对方向；D5 的项目 CPL 角度为 270°，同时以 PCB 阴极丝印和嘉立创预览为准。
