xuxian2102/autolock/reports/final-review/all_layers_montage.png

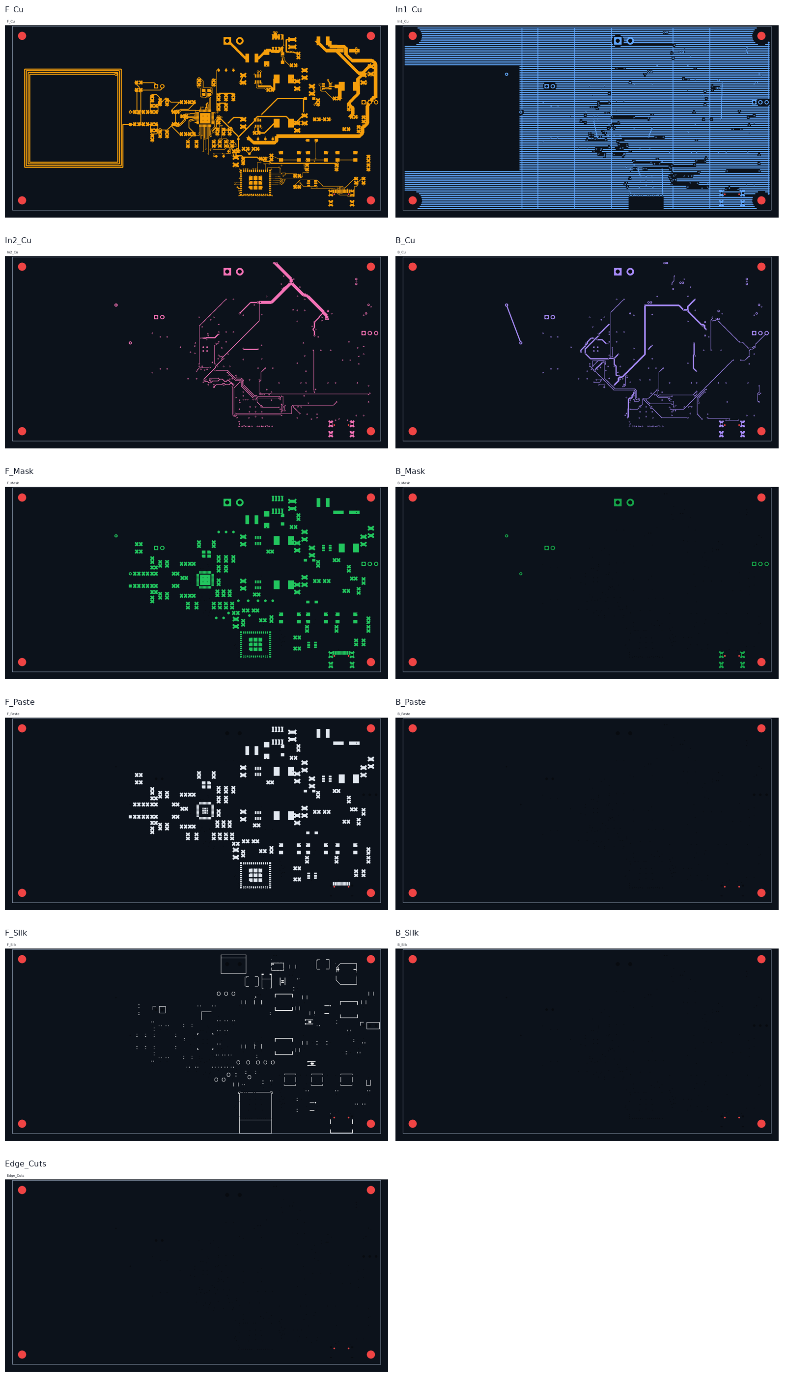
reports/final-review/all_layers_montage.png
