xuxian2102/autolock/reports/final-review/official_all_layers_montage.png

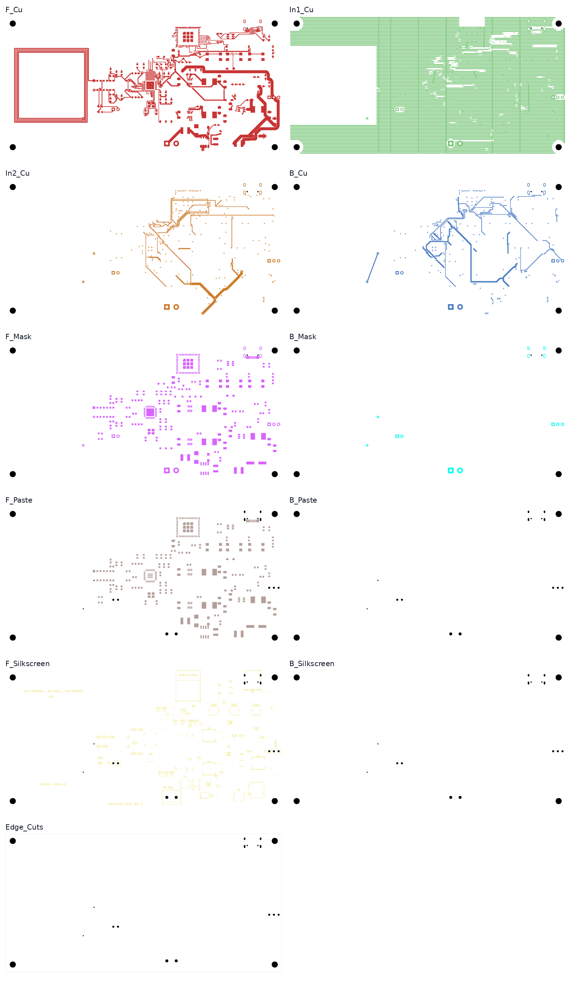
reports/final-review/official_all_layers_montage.png
