xuxian2102/autolock/reports/layers/top_assembly.png

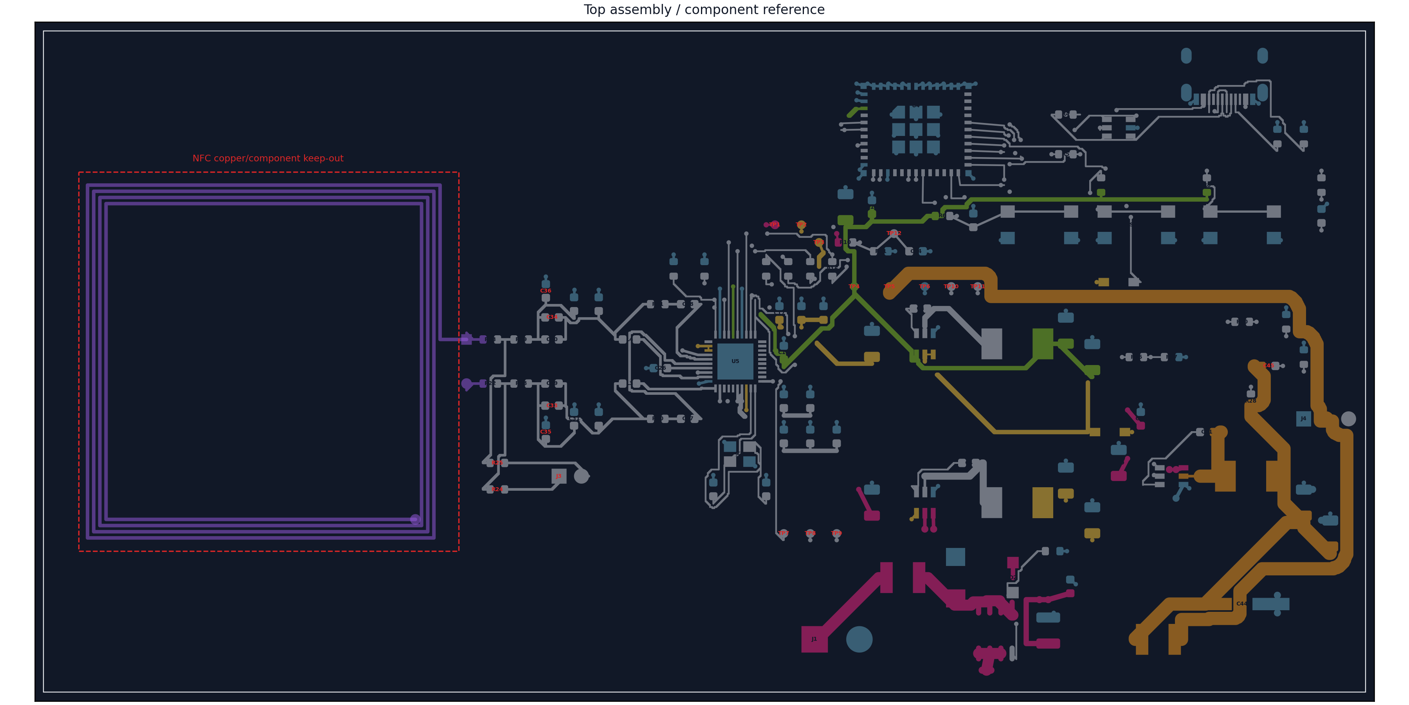
reports/layers/top_assembly.png
