xuxian2102/autolock/hardware/docs/HomeKey-Lock-RevA-Schematics.pdf

1 | 2 | 3 | 4 | 5 | 6 | 7 | 8 | 9 | 10 | 11

A

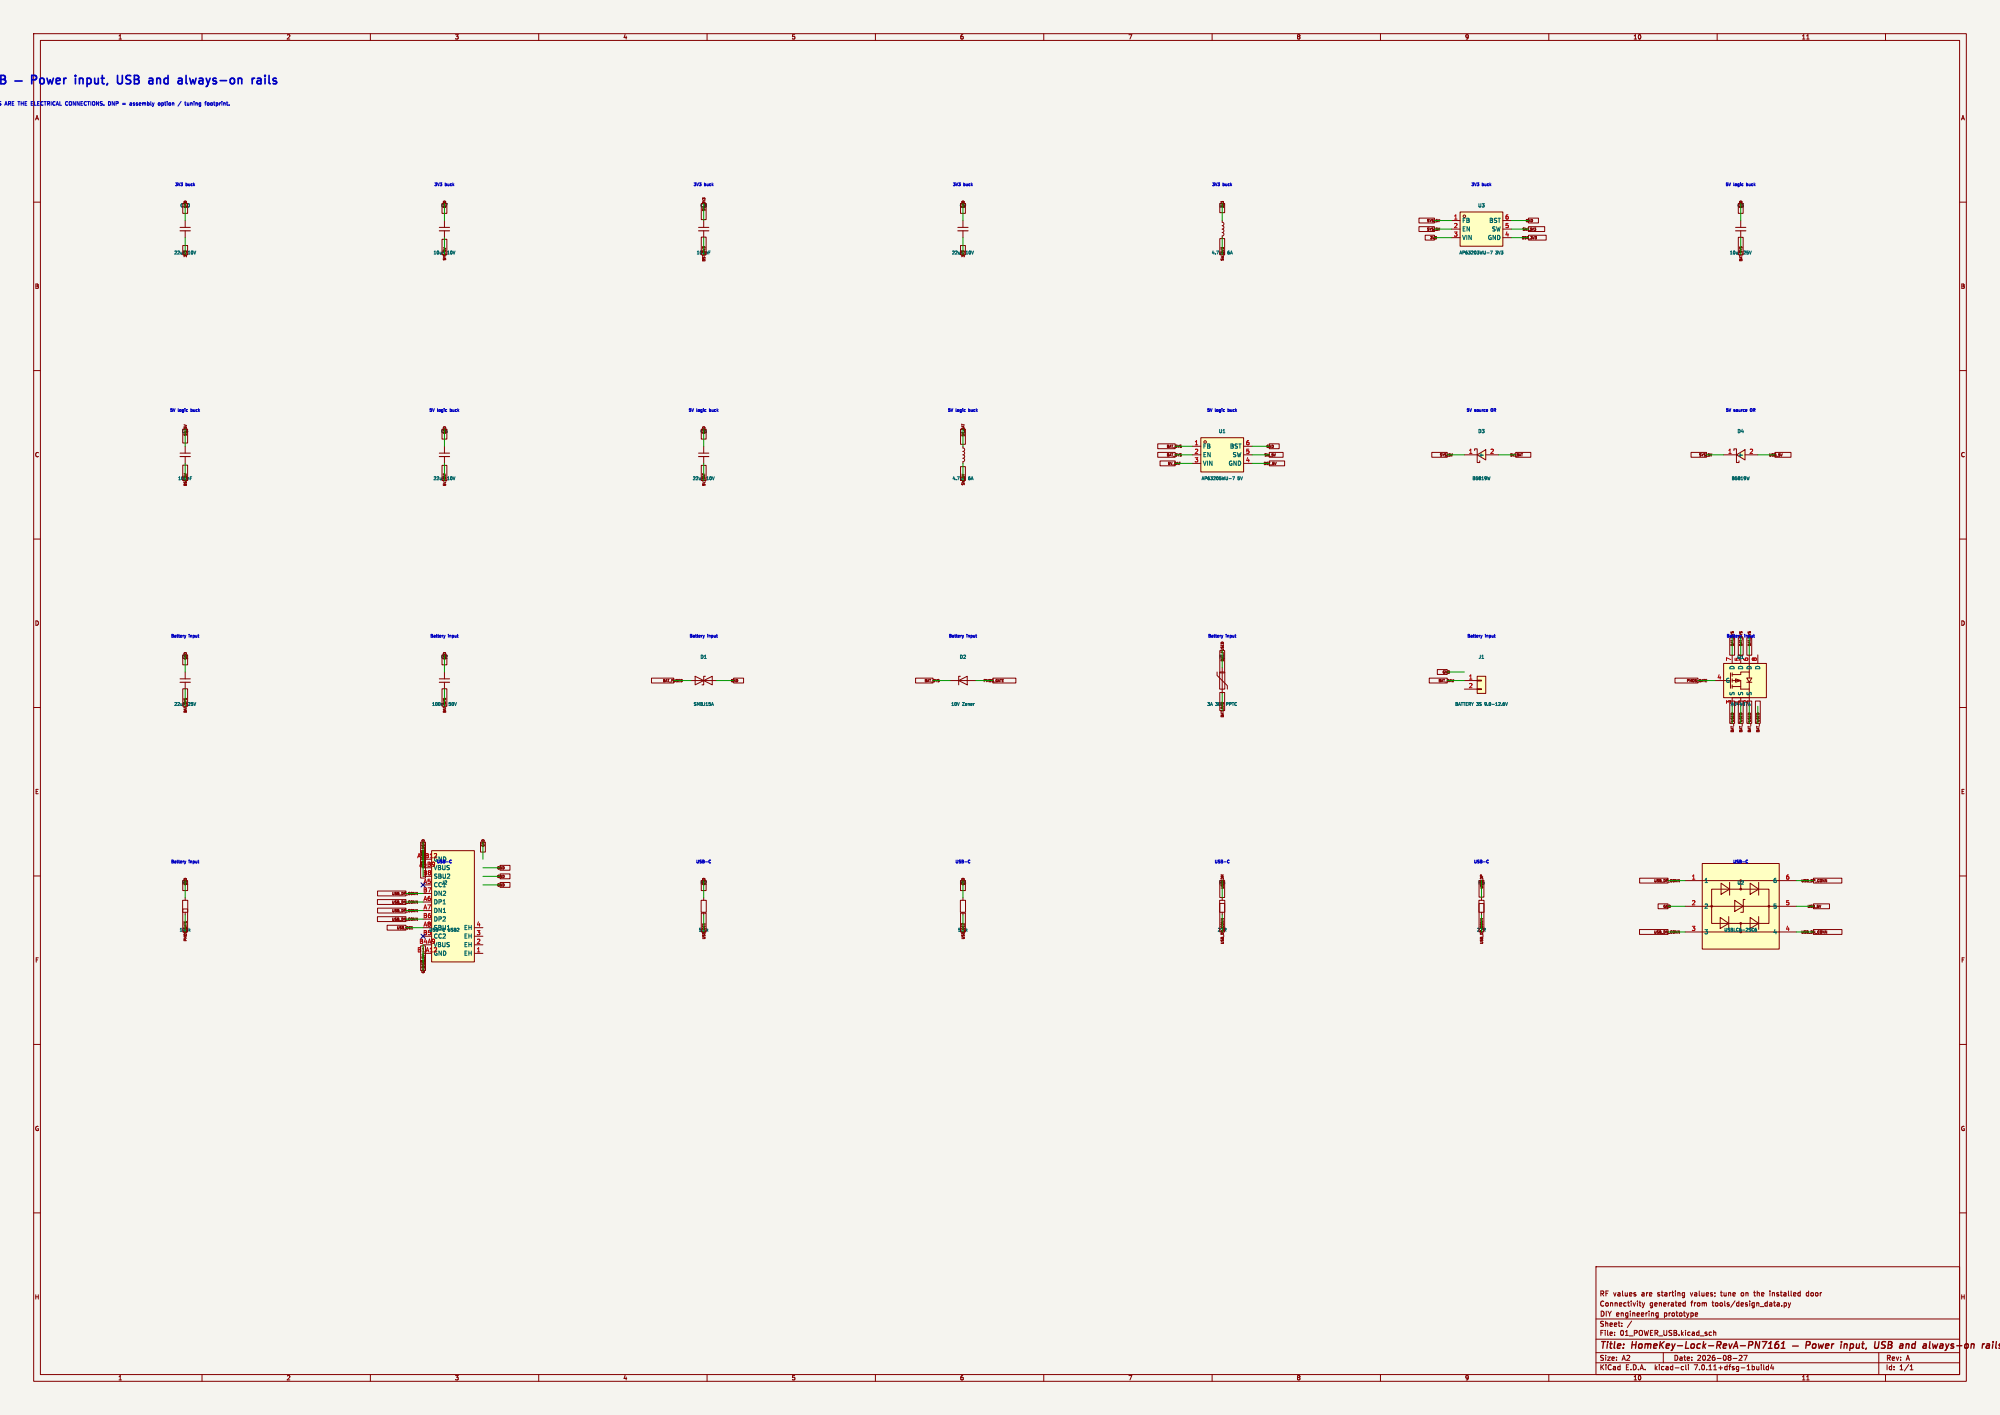
[picture p30: page 1]

USB_DP_CONN GND
EH 1 EH 2 EH 3 EH 4 GND A1B12VBUS A4B9CC1 A5 DP1 A6 DN1 A7 SBU1 A8 GND B1A12VBUS B4A9CC2 B5 DP2 B6 DN2 B7 SBU2 B8

BC

BC

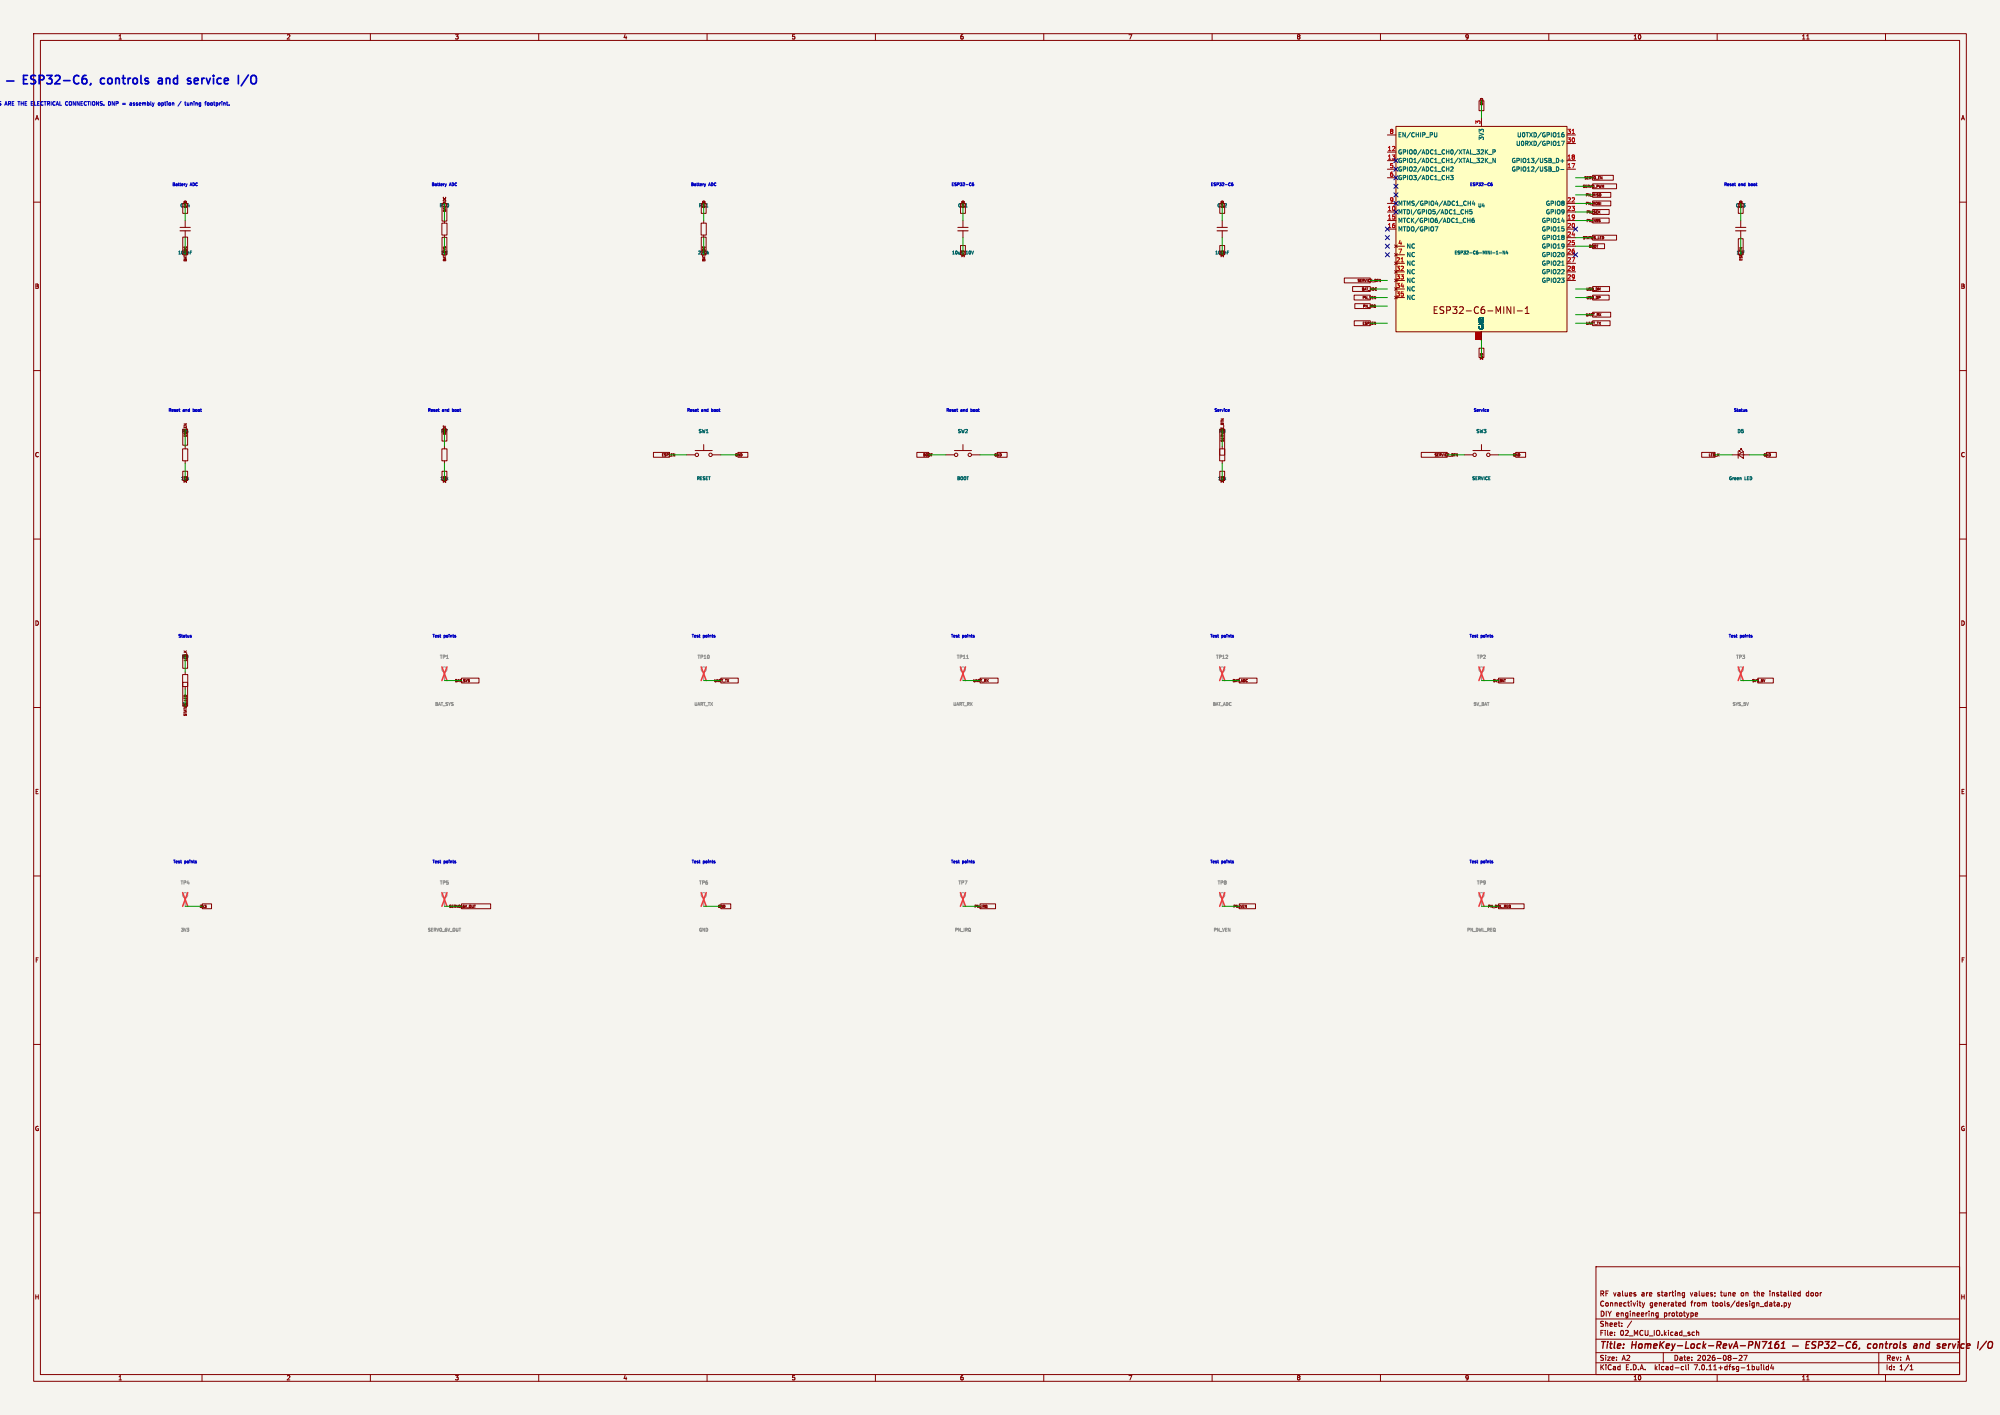
[picture p31: page 2]

D5 Green LED ESP32-C6-MINI-1 GND

Reset and boot Status

BC

BC

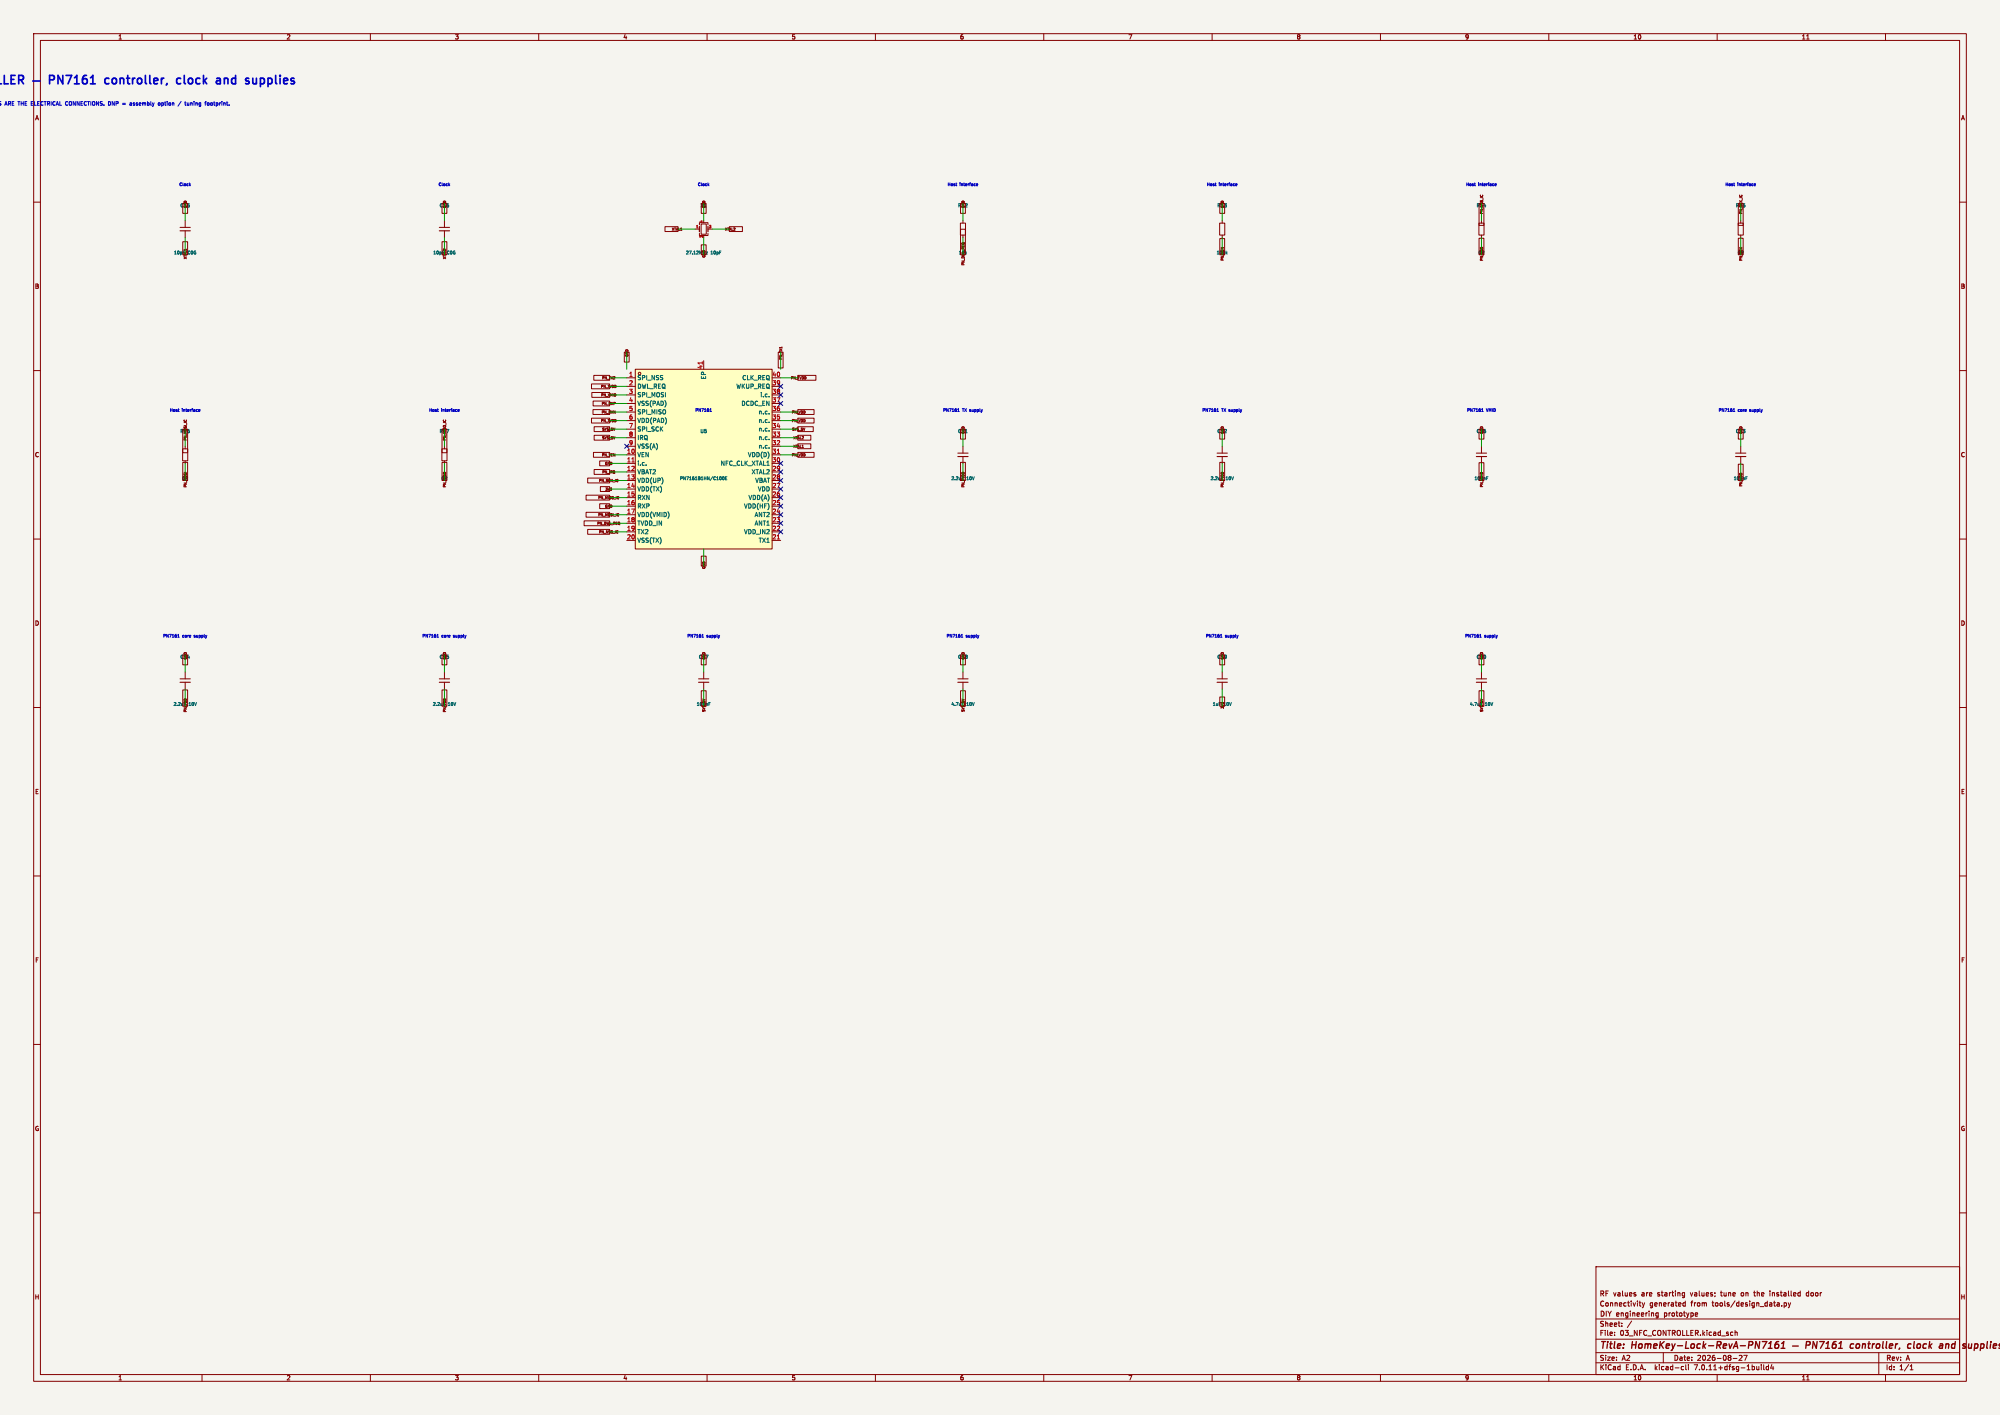
[picture p32: page 3]

BC

BC

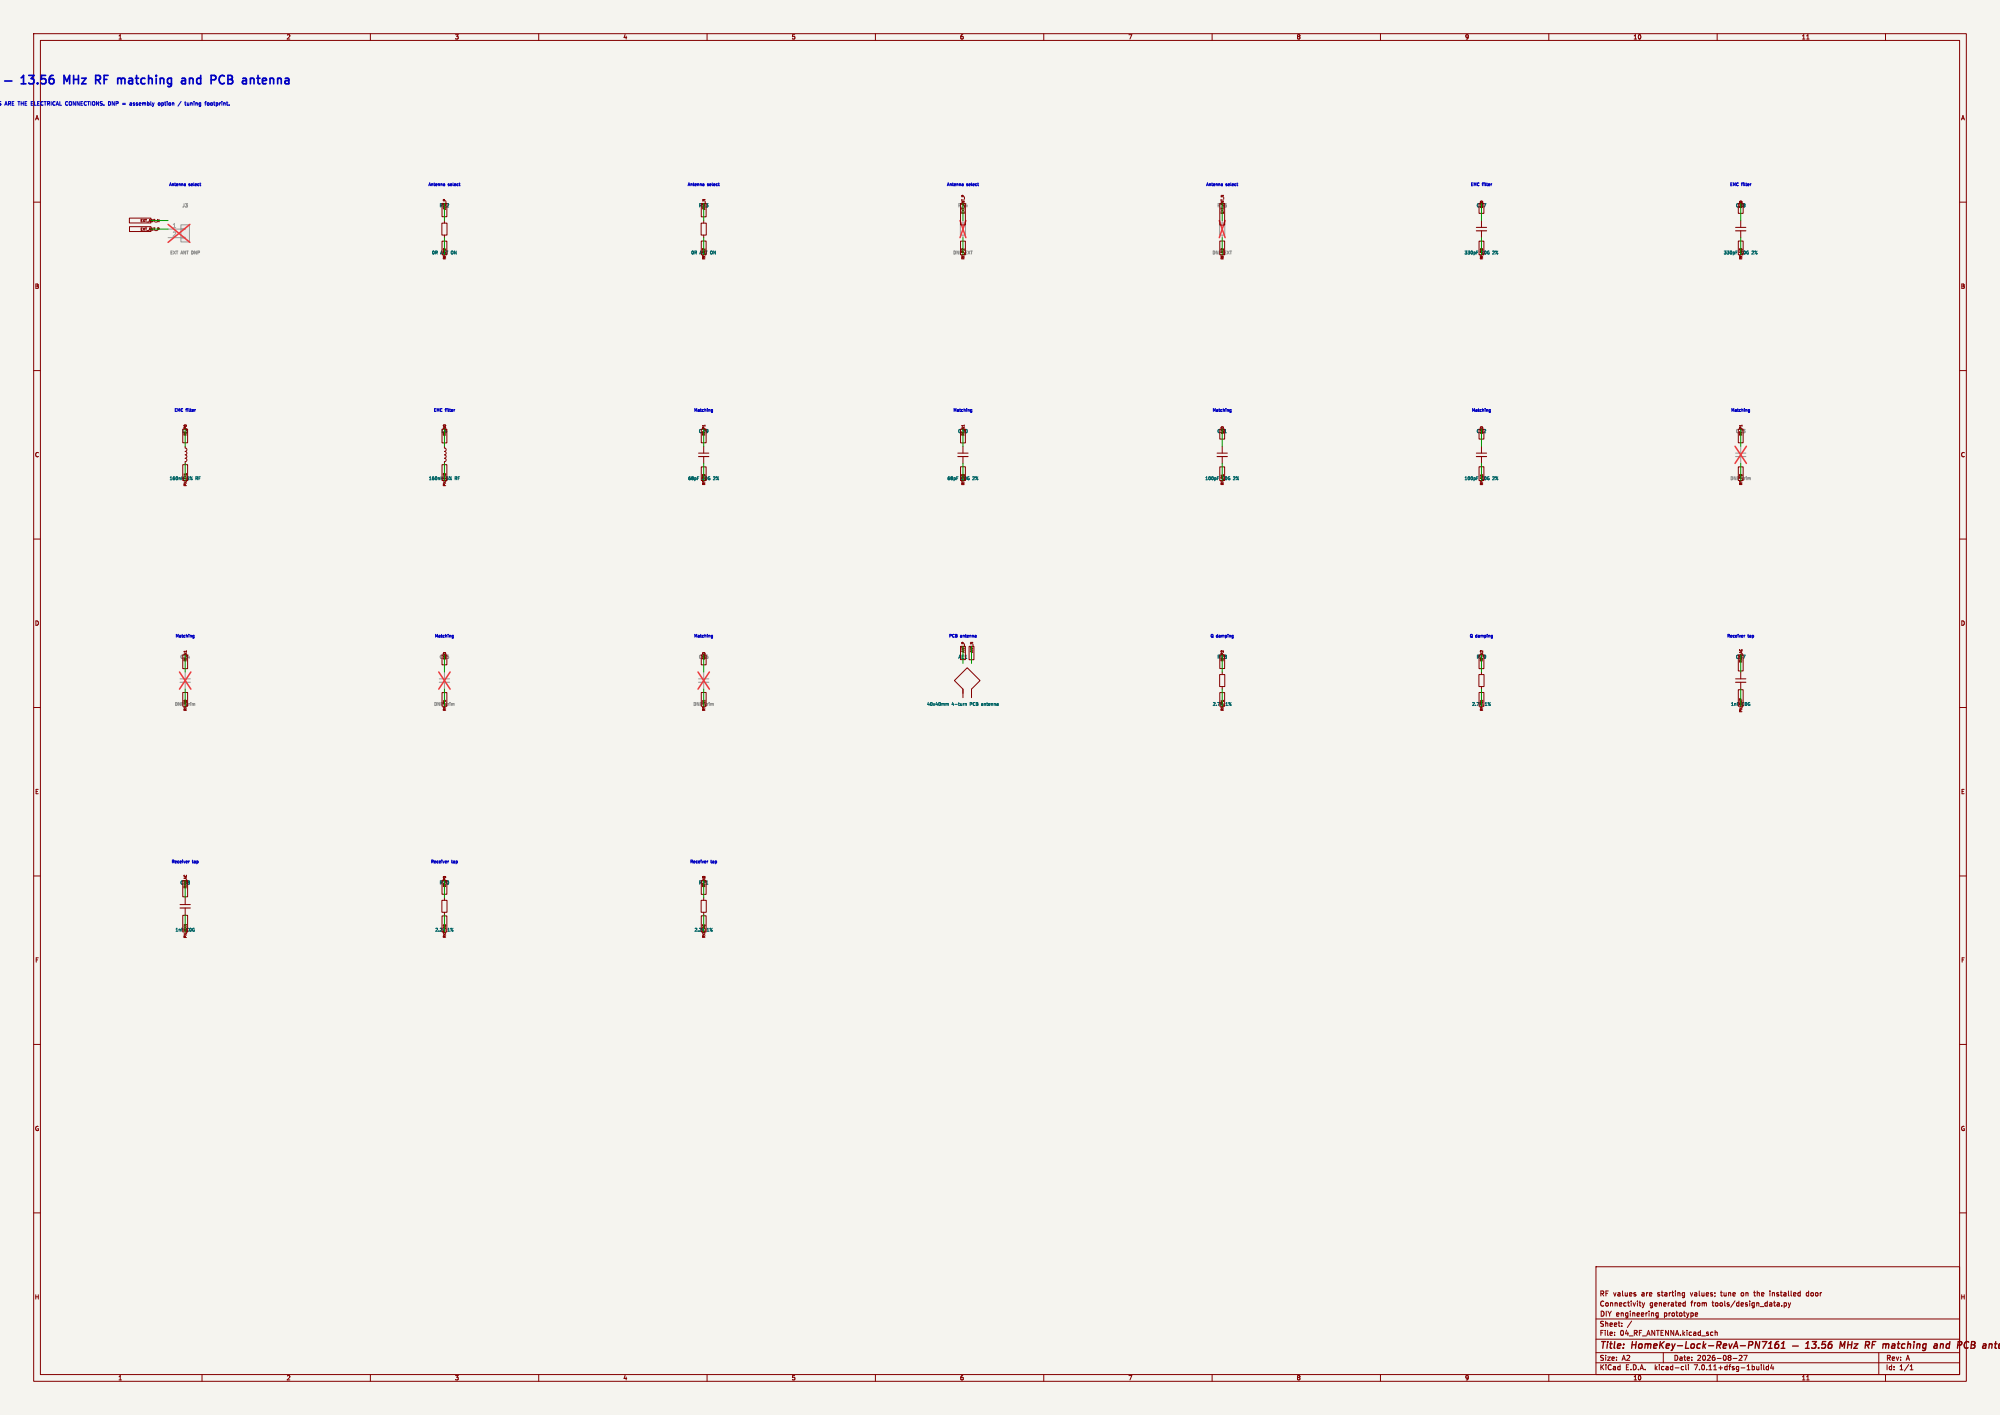
[picture p33: page 4]

EMC filter 04 RF ANTENNA þÿ 13.56 MHz RF matching and PCB antenna

Antenna select EMC filter

BC

BC

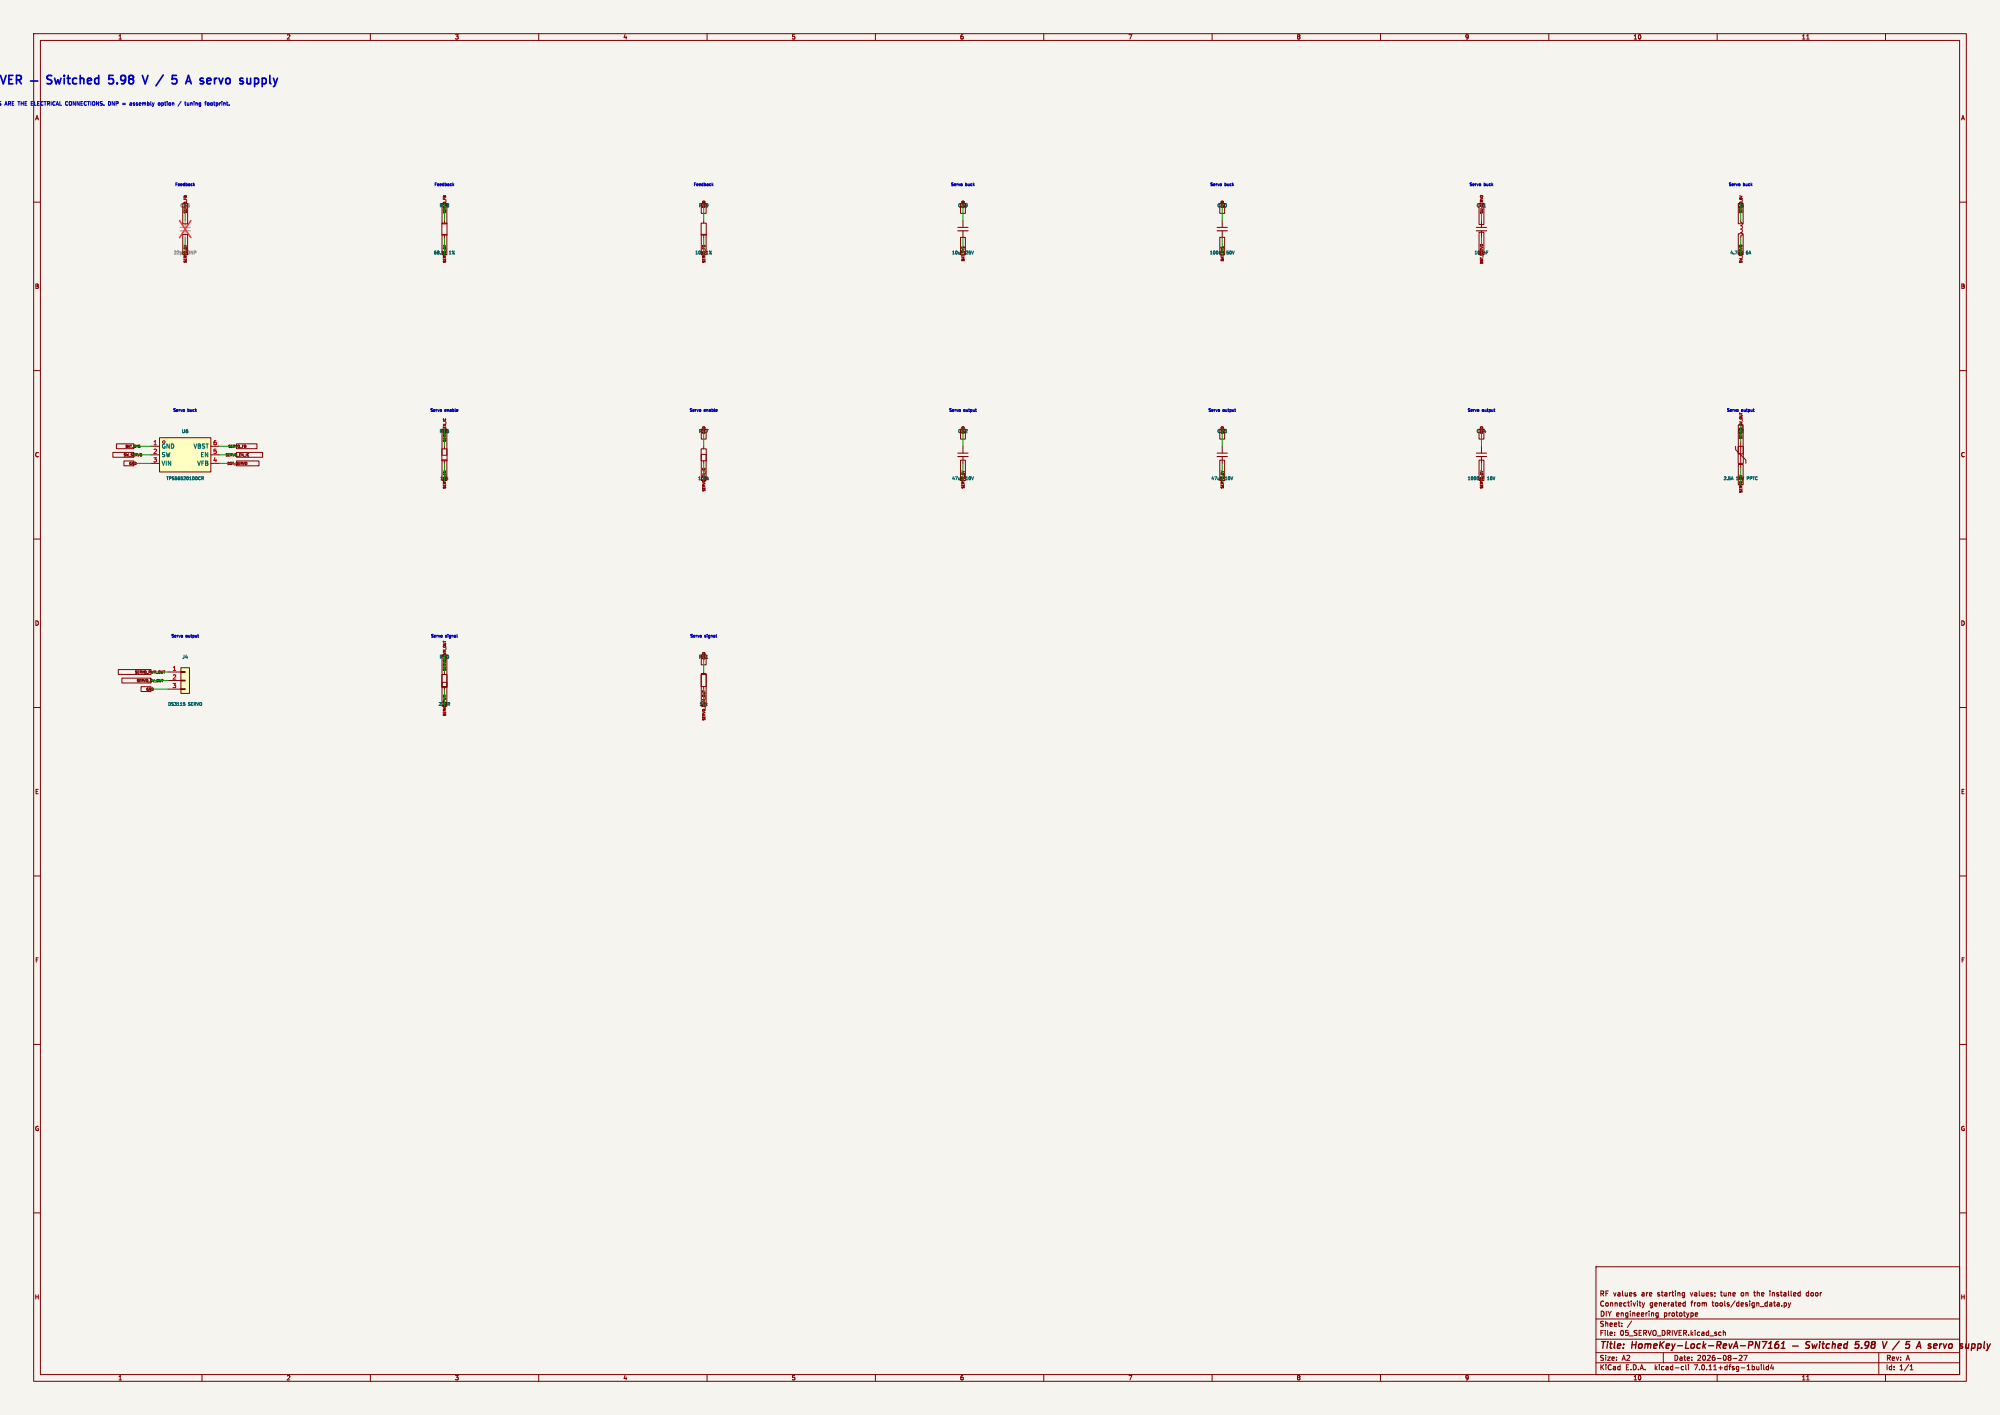
[picture p34: page 5]

Feedback 05 SERVO DRIVER þÿ Switched 5.98 V / 5 A servo supply
