xuxian2102/autolock/hardware/docs/schematic-pages/02_MCU_IO.pdf

D5 Green LED ESP32-C6-MINI-1 GND

Reset and boot Status
