xuxian2102/autolock/hardware/docs/schematic-pages/05_SERVO_DRIVER.pdf

Feedback 05 SERVO DRIVER þÿ Switched 5.98 V / 5 A servo supply
