xuxian2102/autolock/hardware/kicad/HomeKey-Lock-RevA-PN7161.kicad_pcb

## KiCad design hardware/kicad/HomeKey-Lock-RevA-PN7161.kicad_pcb (2026-08-31)

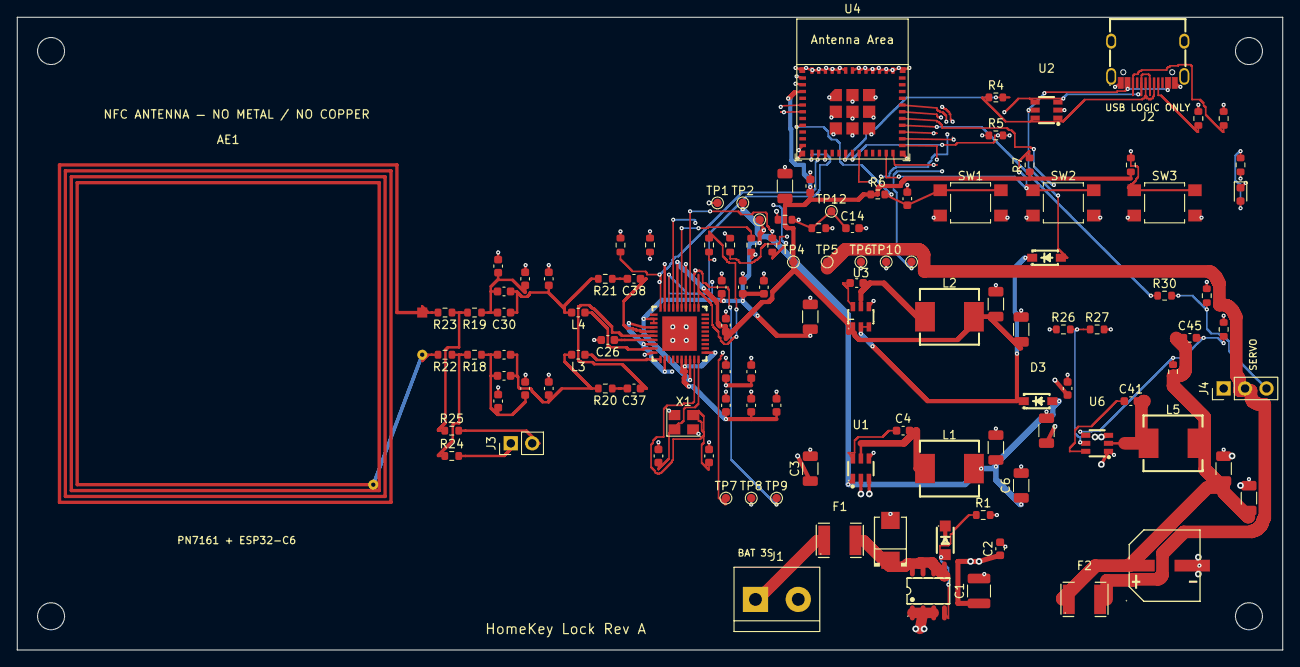
[picture p35: board HomeKey-Lock-RevA-PN7161.kicad_pcb from above]

Board: 4 copper layers, 150.0 x 75.0 mm, 120 parts (0 on the bottom side), 68 nets.

Parts:
AE1: 40x40mm 4-turn PCB antenna; NFC_Antenna_40x40_4T
C1: 22uF 25V; C_1210_3225Metric
C2: 100nF 50V; C_0603_1608Metric_ValueHidden
C3: 10uF 25V; C_1206_3216Metric_ValueHidden
C4, C8, C14, C41: 100nF; C_0603_1608Metric
C5, C9, C10: 22uF 10V; C_1206_3216Metric_FabRef
C6: 22uF 10V; C_1206_3216Metric_ValueHidden
C7, C11: 10uF 10V; C_1206_3216Metric_FabRef
C12, C17, C23: 100nF; C_0603_1608Metric_FabRef
C13: 1uF; C_0603_1608Metric_FabRef
C15, C16: 10pF C0G; C_0603_1608Metric_FabRef
C18, C20: 4.7uF 10V; C_0603_1608Metric_FabRef
C19: 1uF 10V; C_0603_1608Metric_FabRef
C21, C22, C24, C25: 2.2uF 10V; C_0603_1608Metric_FabRef
C26: 100nF; C_0603_1608Metric_ValueHidden
C27, C28: 330pF C0G 2%; C_0603_1608Metric_FabRef
C29: 68pF C0G 2%; C_0603_1608Metric_FabRef
C30: 68pF C0G 2%; C_0603_1608Metric_ValueHidden
C31, C32: 100pF C0G 2%; C_0603_1608Metric_FabRef
C33, C34, C35, C36: DNP trim; C_0603_1608Metric_FabRef
C37, C38: 1nF C0G; C_0603_1608Metric_ValueHidden
C39: 10uF 25V; C_1206_3216Metric_FabRef
C40: 100nF 50V; C_0603_1608Metric_FabRef
C42, C43: 47uF 10V; C_1206_3216Metric_FabRef
C44: 1000uF 10V; CAP-SMD_BD8.0-L8.3-W8.3-FD
C45: 22pF DNP; C_0603_1608Metric
D1: SMBJ15A; SMB_L4.6-W3.6-LS5.3-RD
D2: 10V Zener; SOD-123FL_L2.6-W1.6-LS3.5-R-FD
D3, D4: B5819W; SOD-123_L2.7-W1.6-LS3.7-RD-1
D5: Green LED; LED_0603_1608Metric
F1: 3A 30V PPTC; F1812
F2: 2.5A 16V PPTC; F1812
H1, H2, H3, H4: M3; MountingHole_3.2mm_M3
J1: BATTERY 3S 9.0-12.6V; TerminalBlock_1x02_P5.08mm
J2: USB-C USB2; USB-C_SMD-TYPE-C-31-M-12_1
J3: EXT ANT DNP; PinHeader_1x02_P2.54mm_Vertical
J4: DS3115 SERVO; PinHeader_1x03_P2.54mm_Vertical
L1, L2, L5: 4.7uH 6A; IND-SMD_L7.0-W6.6_APH0630
L3, L4: 160nH 5% RF; L_0603_1608Metric
Q1: AO4407A; SOIC-8_L4.9-W3.9-P1.27-LS6.0-BL
R1, R27: 100k; R_0603_1608Metric
R2, R3: 5.1k; R_0603_1608Metric_FabRef
R4, R5: 22R; R_0603_1608Metric
R6, R26: 10k; R_0603_1608Metric
R7: 10k; R_0603_1608Metric_ValueHidden
R8, R12, R31: 10k; R_0603_1608Metric_FabRef
R9: 1k; R_0603_1608Metric_FabRef
R10: 1M; R_0603_1608Metric
R11: 220k; R_0603_1608Metric
R13: 100k; R_0603_1608Metric_FabRef
R14, R15, R16, R17: 0R; R_0603_1608Metric_FabRef
R18, R19: 2.7R 1%; R_0603_1608Metric_ValueHidden
R20, R21: 2.2k 1%; R_0603_1608Metric_ValueHidden
R22, R23: 0R ANT ON; R_0603_1608Metric_ValueHidden
R24, R25: DNP EXT; R_0603_1608Metric
R28: 68.1k 1%; R_0603_1608Metric_FabRef
R29: 10k 1%; R_0603_1608Metric_FabRef
R30: 220R; R_0603_1608Metric
SW1: RESET; SW_SPST_TL3305A
SW2: BOOT; SW_SPST_TL3305A
SW3: SERVICE; SW_SPST_TL3305A
TP1: BAT_SYS; TestPoint_Pad_D1.0mm
TP2: 5V_BAT; TestPoint_Pad_D1.0mm
TP3: SYS_5V; TestPoint_Pad_D1.0mm
TP4: 3V3; TestPoint_Pad_D1.0mm
TP5: SERVO_6V_OUT; TestPoint_Pad_D1.0mm
TP6: GND; TestPoint_Pad_D1.0mm
TP7: PN_IRQ; TestPoint_Pad_D1.0mm
TP8: PN_VEN; TestPoint_Pad_D1.0mm
TP9: PN_DWL_REQ; TestPoint_Pad_D1.0mm
TP10: UART_TX; TestPoint_Pad_D1.0mm
TP11: UART_RX; TestPoint_Pad_D1.0mm
TP12: BAT_ADC; TestPoint_Pad_D1.0mm
U1: AP63205WU-7 5V; TSOT-23-6_L2.9-W1.6-P0.95-LS2.8-BL
U2: USBLC6-2SC6; SOT-23-6_L2.9-W1.6-P0.95-LS2.8-BR
U3: AP63203WU-7 3V3; TSOT-26_L2.9-W1.6-P0.95-LS2.8-BL
U4: ESP32-C6-MINI-1-N4; ESP32-C6-MINI-1
U5: PN7161B1HN/C100E; HVQFN-40_L6.0-W6.0-P0.50-BL-EP4.1
U6: TPS565201DDCR; SOT-23-6_L2.9-W1.6-P0.95-LS2.8-BR
X1: 27.12MHz 10pF; Crystal_SMD_3225-4Pin_3.2x2.5mm

Connections:
3V3: C9.1, C10.1, C11.1, C12.1, C19.1, L2.2, R6.1, R7.1, R8.1, TP4.1, U3.1, U4.3, U5.6
5V_BAT: C5.1, C6.1, D3.2, L1.2, TP2.1, U1.1
ANT_N: AE1.1, R23.2
ANT_P: AE1.2, R22.2
BAT_ADC: C14.1, R10.2, R11.1, TP12.1, U4.5
BAT_FUSED: D1.1, F1.2, Q1.5, Q1.6, Q1.7, Q1.8
BAT_RAW: F1.1, J1.1
BAT_SYS: C1.1, C2.1, C3.1, C39.1, C40.1, D2.1, Q1.1, Q1.2, Q1.3, R10.1, TP1.1, U1.2, U1.3, U6.3
BOOT: R7.2, SW2.1, U4.23
BST_3V3: C8.1, U3.6
BST_5V: C4.1, U1.6
BST_SERVO: C41.1, U6.6
ESP_EN: C13.1, R6.2, SW1.1, U4.8
EXT_ANT_N: J3.2, R25.2
EXT_ANT_P: J3.1, R24.2
GND: C1.2, C2.2, C3.2, C5.2, C6.2, C7.2, C9.2, C10.2, C11.2, C12.2, C13.2, C14.2, C15.2, C16.2, C17.2, C18.2, C19.2, C20.2, C21.2, C22.2, C23.2, C24.2, C25.2, C26.2, C27.2, C28.2, C31.2, C32.2, C35.2, C36.2, C39.2, C40.2, C42.2, C43.2, C44.2, D1.2, D5.1, J1.2, J2.1, J2.2, J2.3, J2.4, J2.A1B12, J2.B1A12, J4.1, R1.2, R2.2, R3.2, R11.2, R12.2, R13.2, R27.2, R29.2, R31.2, SW1.2, SW2.2, SW3.2, TP6.1, U1.4, U2.2, U3.4, U4.1, U4.2, U4.11, U4.14, U4.36, U4.37, U4.38, U4.39, U4.40, U4.41, U4.42, U4.43, U4.44, U4.45, U4.46, U4.47, U4.48, U4.49, U4.50, U4.51, U4.52, U4.53, U5.4, U5.9, U5.20, U5.41, U6.1, X1.2, X1.4
LED_A: D5.2, R9.2
PMOS_GATE: D2.2, Q1.4, R1.1
PN_DWL_REQ: R12.1, TP9.1, U5.2
PN_IRQ: TP7.1, U4.12, U5.8
PN_MISO: R17.1, U4.27
PN_MISO_IC: R17.2, U5.5
PN_MOSI: R16.1, U4.26
PN_MOSI_IC: R16.2, U5.3
PN_NSS: R14.1, U4.24
PN_NSS_IC: R14.2, U5.1
PN_RXN: C38.1, U5.15
PN_RXP: C37.1, U5.16
PN_SCK: R15.1, U4.25
PN_SCK_IC: R15.2, U5.7
PN_TVDD: C21.1, C22.1, U5.14, U5.18, U5.22
PN_TX1: L3.1, U5.21
PN_TX2: L4.1, U5.19
PN_VDD: C23.1, C24.1, C25.1, U5.26, U5.27, U5.31
PN_VEN: R13.1, TP8.1, U4.13, U5.10
PN_VMID: C26.1, U5.17
RF_N0: C28.1, C30.1, C34.1, L4.2, R21.2
RF_N1: C30.2, C32.1, C34.2, C36.1, R19.1
RF_N2: R19.2, R23.1, R25.1
RF_P0: C27.1, C29.1, C33.1, L3.2, R20.2
RF_P1: C29.2, C31.1, C33.2, C35.1, R18.1
RF_P2: R18.2, R22.1, R24.1
RXN_AC: C38.2, R21.1
RXP_AC: C37.2, R20.1
SERVICE_BTN: R8.2, SW3.1, U4.6
SERVO_6V: C42.1, C43.1, C44.1, C45.1, F2.1, L5.2, R28.1
SERVO_6V_OUT: F2.2, J4.2, TP5.1
SERVO_EN: R26.1, U4.29
SERVO_EN_IC: R26.2, R27.1, U6.5
SERVO_FB: C45.2, R28.2, R29.1, U6.4
SERVO_PWM: R30.1, U4.28
SERVO_PWM_OUT: J4.3, R30.2, R31.1
STATUS_LED: R9.1, U4.19
SW_3V3: C8.2, L2.1, U3.5
SW_5V: C4.2, L1.1, U1.5
SW_SERVO: C41.2, L5.1, U6.2
SYS_5V: C7.1, C17.1, C18.1, C20.1, D3.1, D4.1, TP3.1, U3.2, U3.3, U5.12, U5.13, U5.28
UART_RX: TP11.1, U4.30
UART_TX: TP10.1, U4.31
USB_5V: D4.2, J2.A4B9, J2.B4A9, U2.5
USB_CC1: J2.A5, R2.1
USB_CC2: J2.B5, R3.1
USB_DM: R4.2, U4.17
USB_DN_CONN: J2.A7, J2.B7, R4.1, U2.1, U2.6
USB_DP: R5.2, U4.18
USB_DP_CONN: J2.A6, J2.B6, R5.1, U2.3, U2.4
XTAL1: C15.1, U5.30, X1.1
XTAL2: C16.1, U5.29, X1.3
